MrDanS-21/gantry-system-23/V1/TechnicalDrawing.pdf

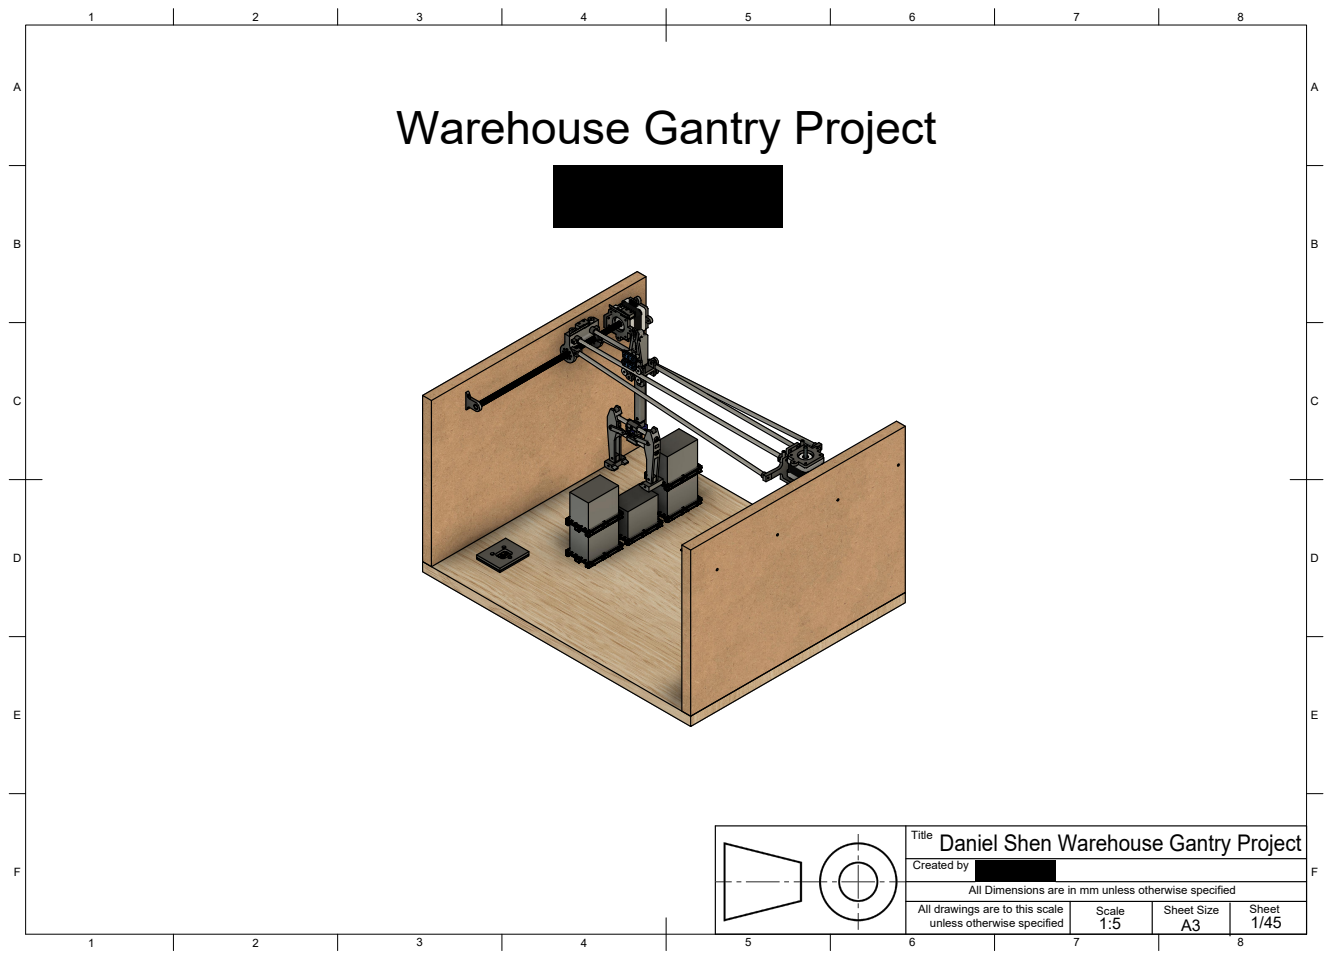
[picture p1: page 1]
Sheet Size; Created by; unless otherwise specified

Warehouse Gantry Project

Title
Daniel Shen Warehouse Gantry Project

All Dimensions are in mm unless otherwise specified

All drawings are to this scale

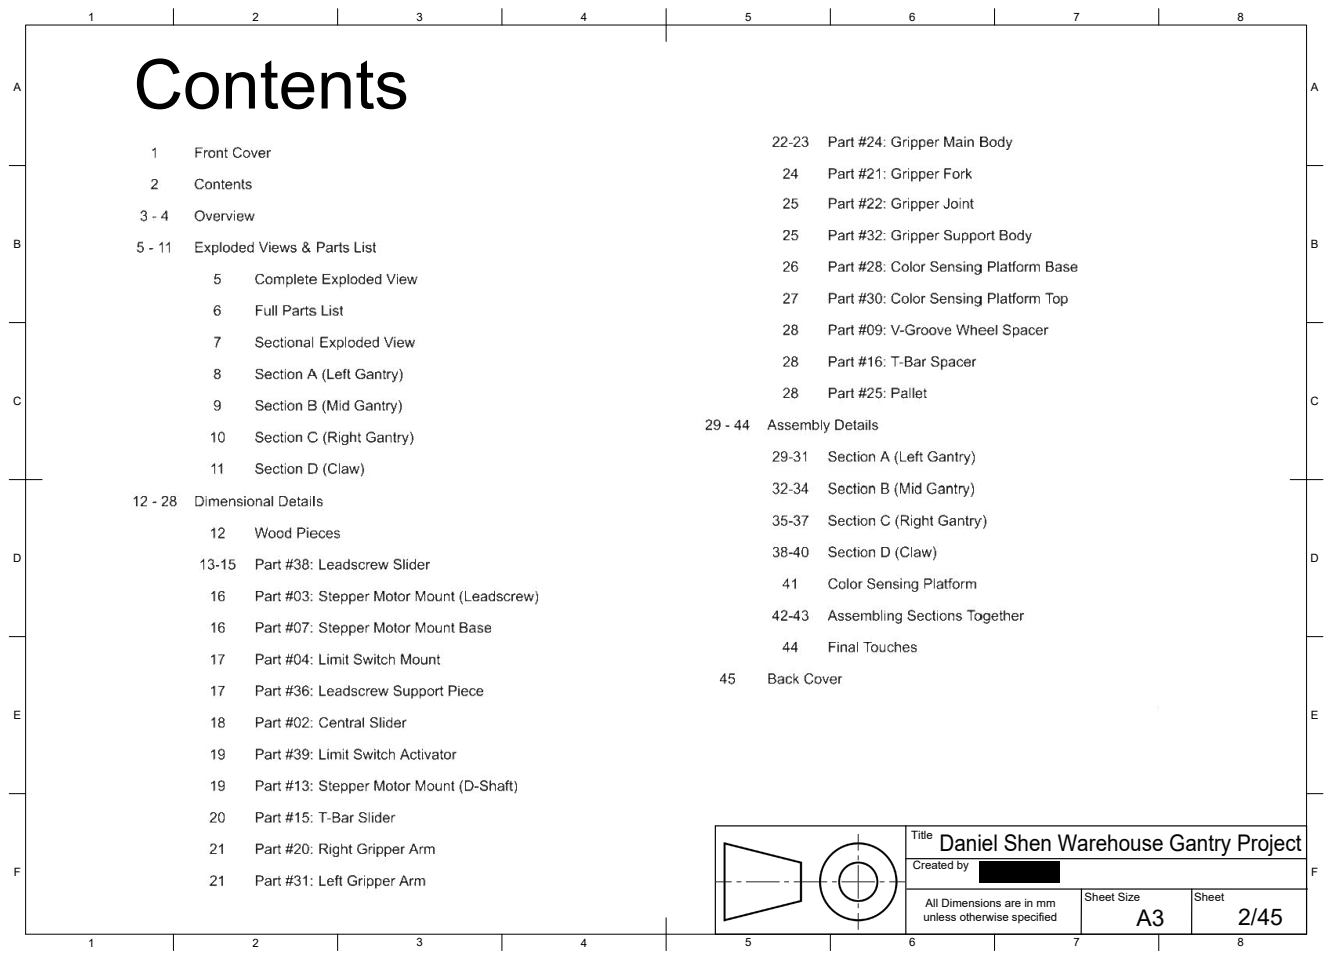
[picture p2: page 2]
Created by

Title
Daniel Shen Warehouse Gantry Project

All Dimensions are in mm

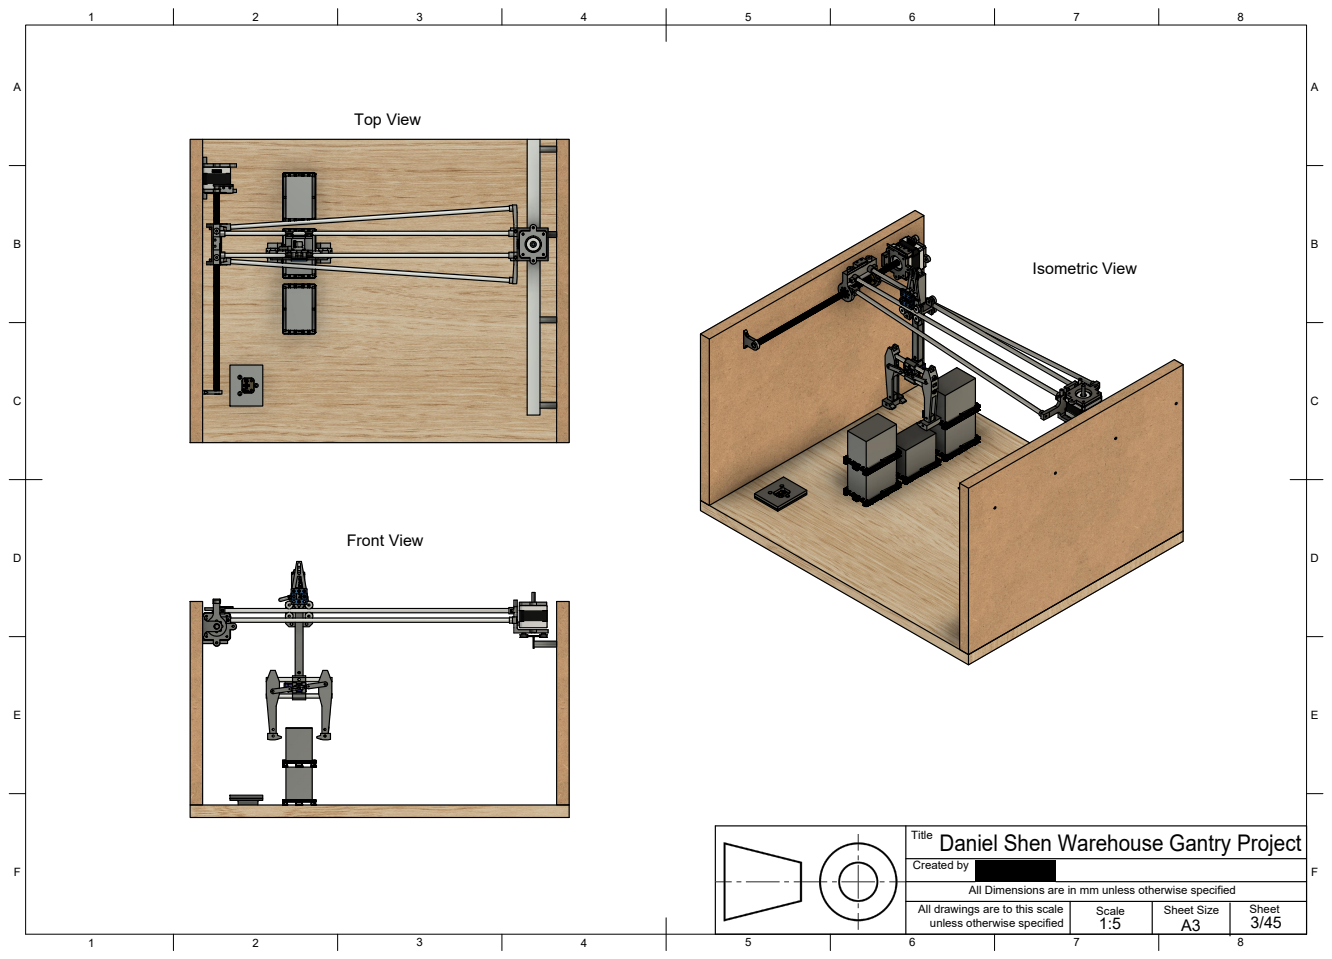
[picture p3: page 3]
Created by; Top View; Front View; Isometric View

Title
Daniel Shen Warehouse Gantry Project

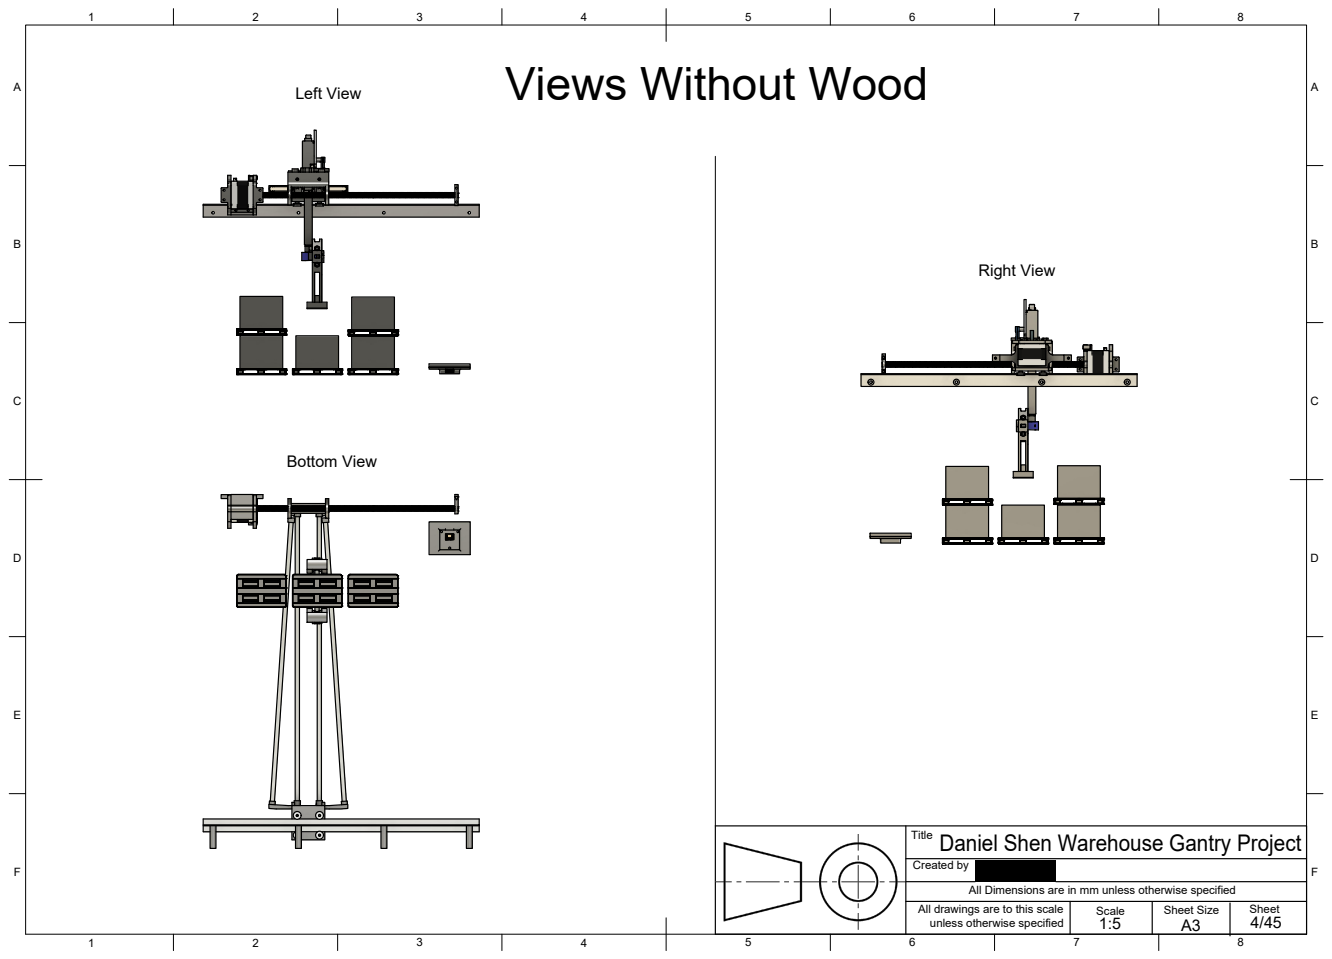
[picture p4: page 4]
Created by; Left View; Bottom View; Right View

Views Without Wood

Title
Daniel Shen Warehouse Gantry Project

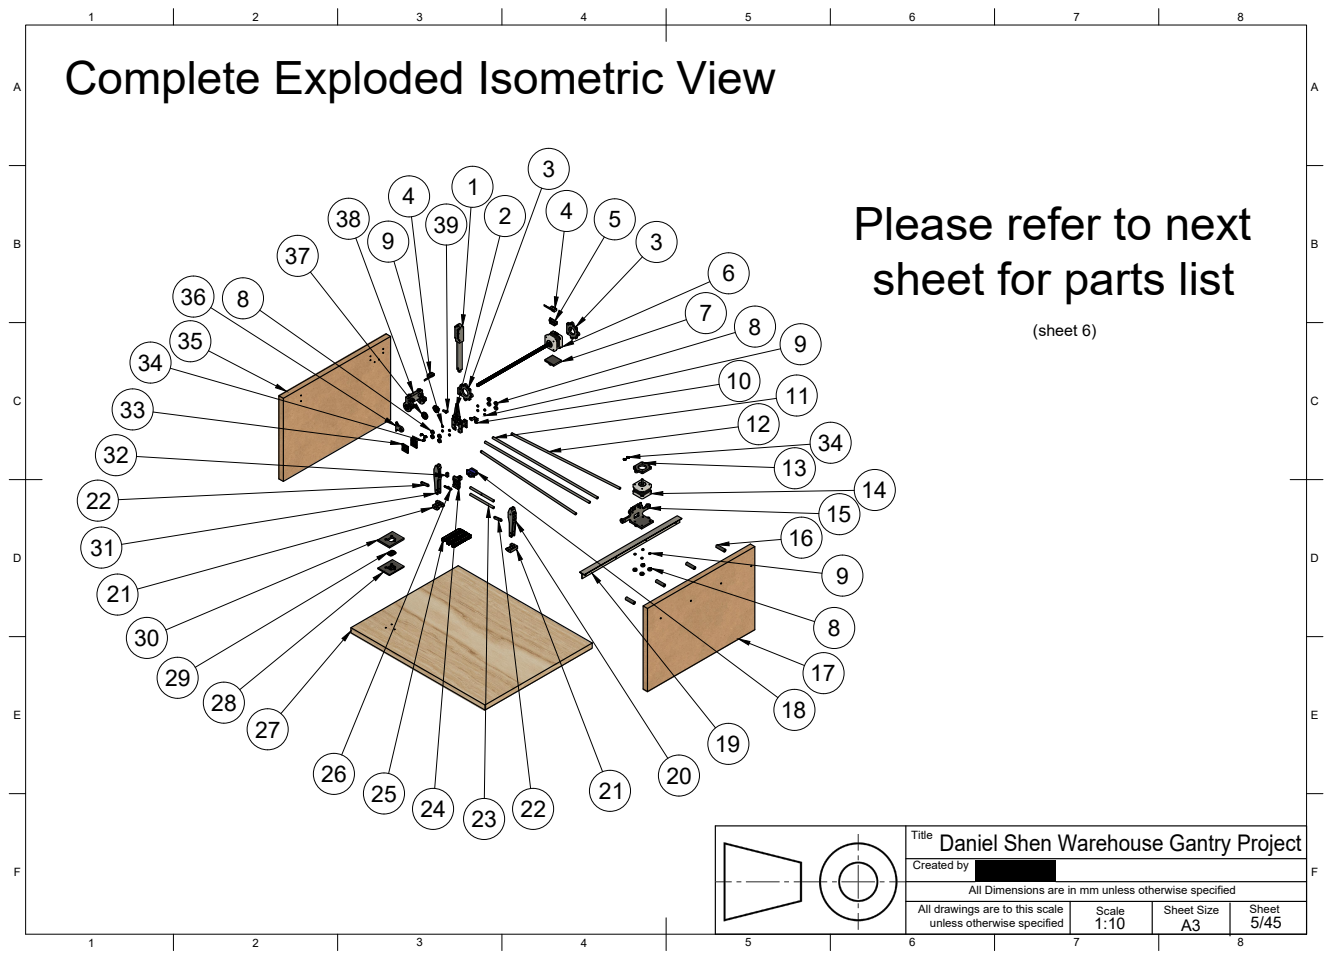
[picture p5: page 5]
Created by; (sheet 6)

Complete Exploded Isometric View

Please refer to next
sheet for parts list

Title
Daniel Shen Warehouse Gantry Project

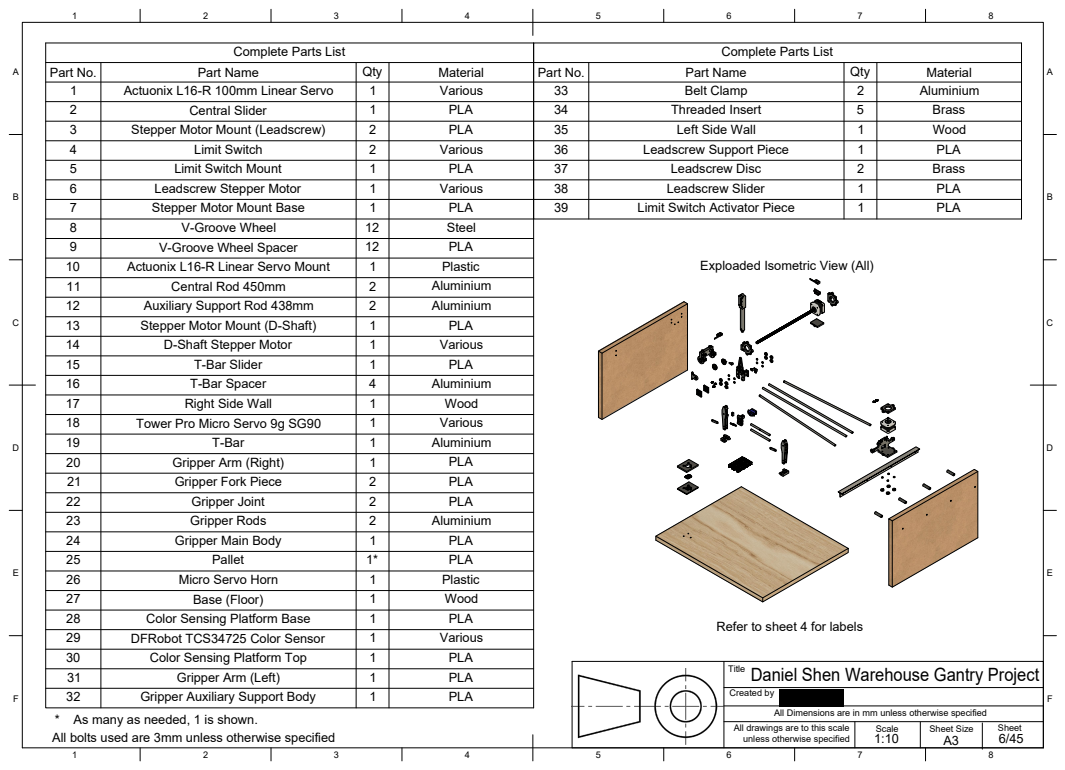
[picture p6: page 6]
Created by; Part No.; Part Name; Qty; Material; Actuonix L16-R 100mm Linear Servo; Various; Central Slider; PLA; Stepper Motor Mount (Leadscrew); Limit Switch; Limit Switch Mount; Leadscrew Stepper Motor; Stepper Motor Mount Base; V-Groove Wheel; Steel; V-Groove Wheel Spacer; Actuonix L16-R Linear Servo Mount; Plastic; Central Rod 450mm; Aluminium; Auxiliary Support Rod 438mm; Stepper Motor Mount (D-Shaft); D-Shaft Stepper Motor; T-Bar Slider; T-Bar Spacer; Right Side Wall; Wood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

Complete Parts List

* As many as needed, 1 is shown.
All bolts used are 3mm unless otherwise specified

Exploaded Isometric View (All)

Refer to sheet 4 for labels

Title
Daniel Shen Warehouse Gantry Project

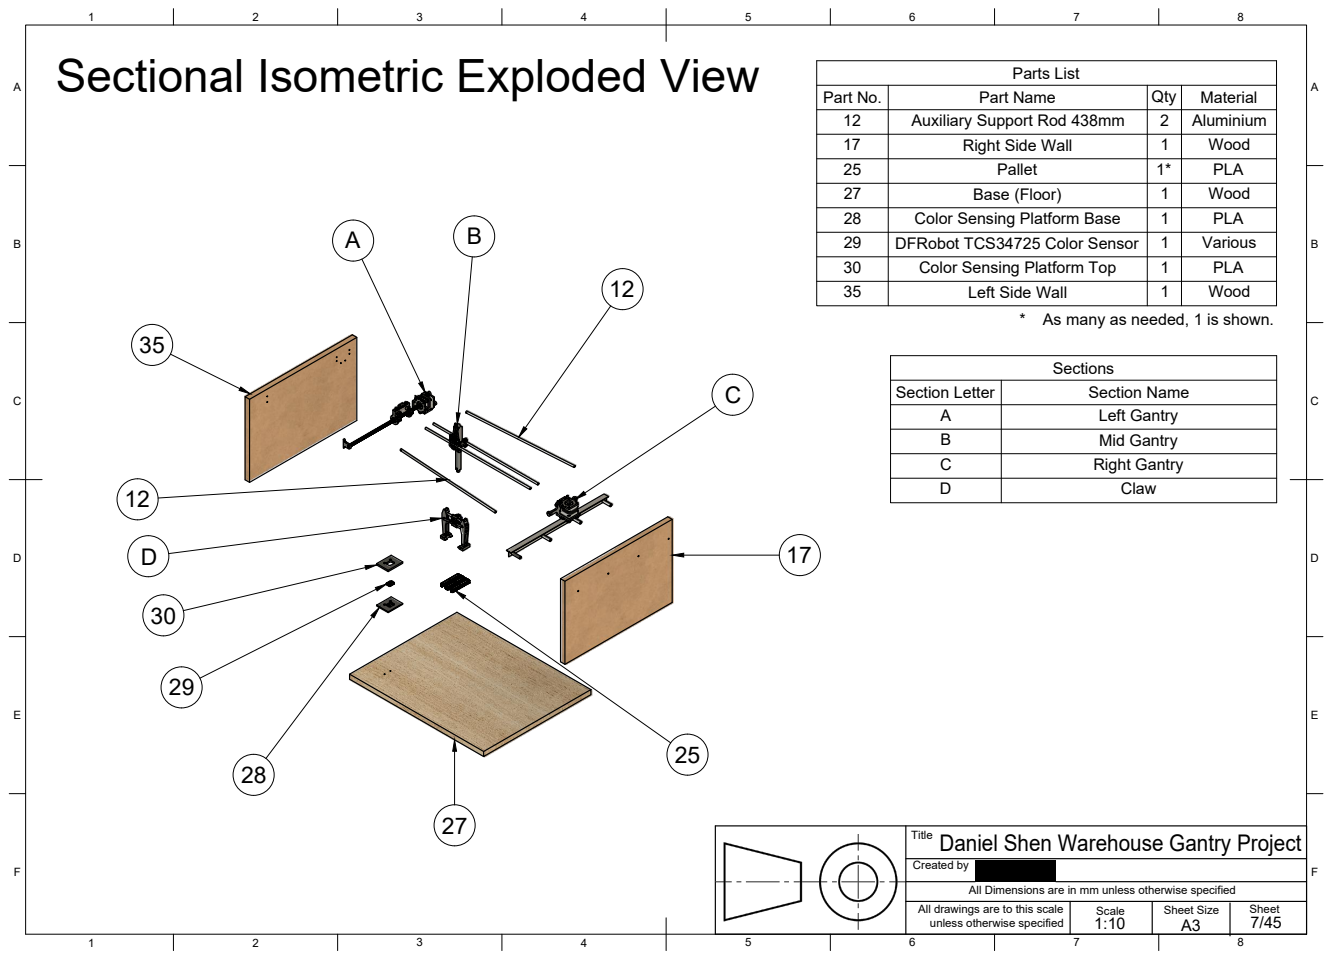
[picture p7: page 7]
Created by; Section Letter; Section Name; Left Gantry; Mid Gantry; Right Gantry; Parts List; Part No.; Part Name; Qty; Material; Auxiliary Support Rod 438mm; Aluminium; Right Side Wall; Wood; Base (Floor); Color Sensing Platform Base; PLA; DFRobot TCS34725 Color Sensor; Various; Color Sensing Platform Top; Left Side Wall

Sectional Isometric Exploded View

* As many as needed, 1 is shown.

Title
Daniel Shen Warehouse Gantry Project

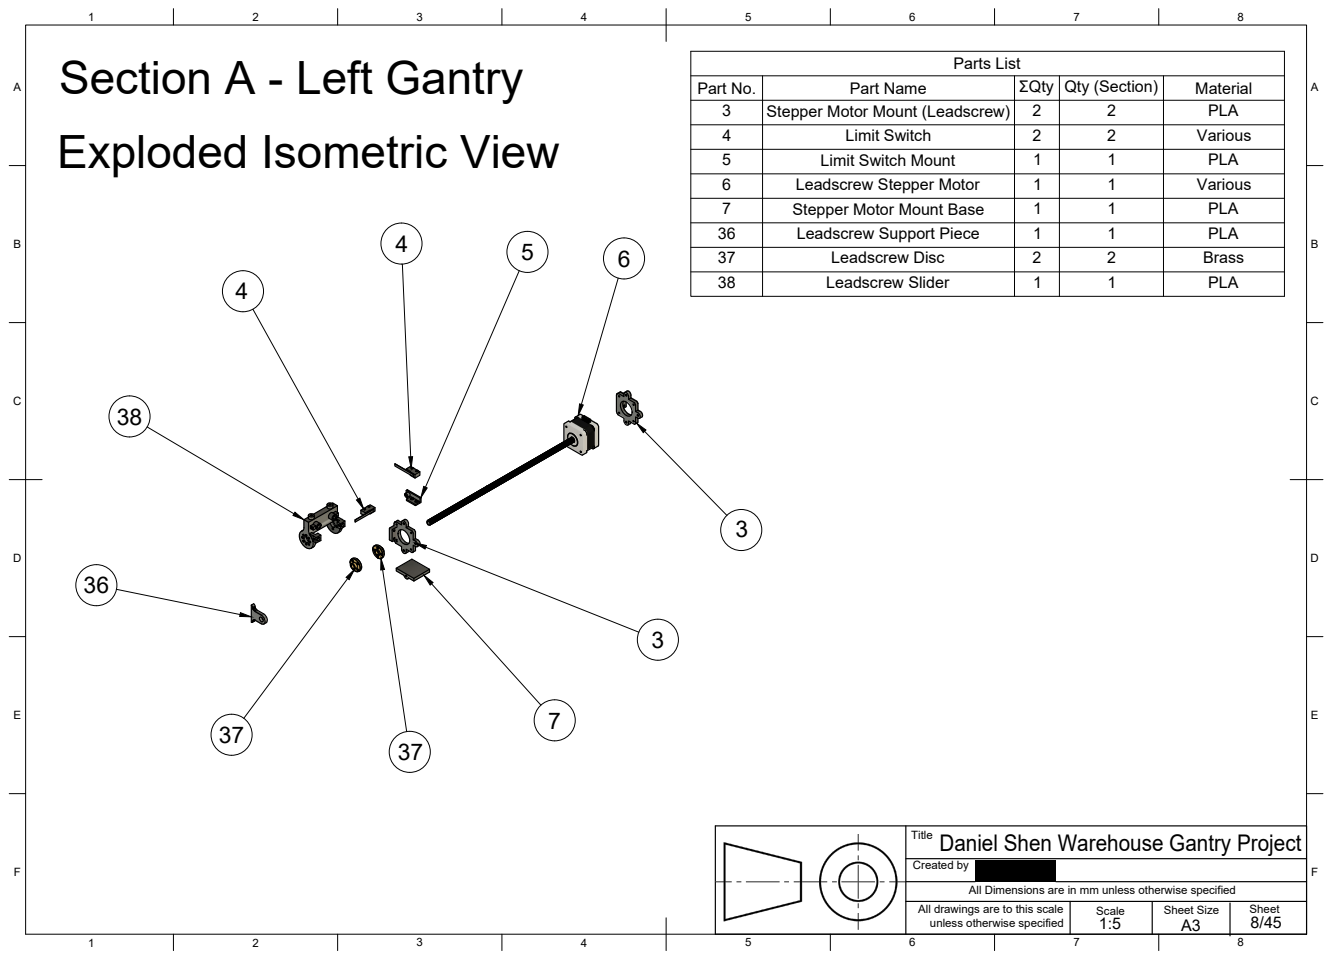
[picture p8: page 8]
Parts List

Section A - Left Gantry
Exploded Isometric View

Part No. | Part Name | ΣQty | Qty (Section) | Material
3 | Stepper Motor Mount (Leadscrew) | 2 | 2 | PLA
4 | Limit Switch | 2 | 2 | Various
5 | Limit Switch Mount | 1 | 1 | PLA
6 | Leadscrew Stepper Motor | 1 | 1 | Various
7 | Stepper Motor Mount Base | 1 | 1 | PLA
36 | Leadscrew Support Piece | 1 | 1 | PLA
37 | Leadscrew Disc | 2 | 2 | Brass
38 | Leadscrew Slider | 1 | 1 | PLA

Title Daniel Shen Warehouse Gantry Project

Created by

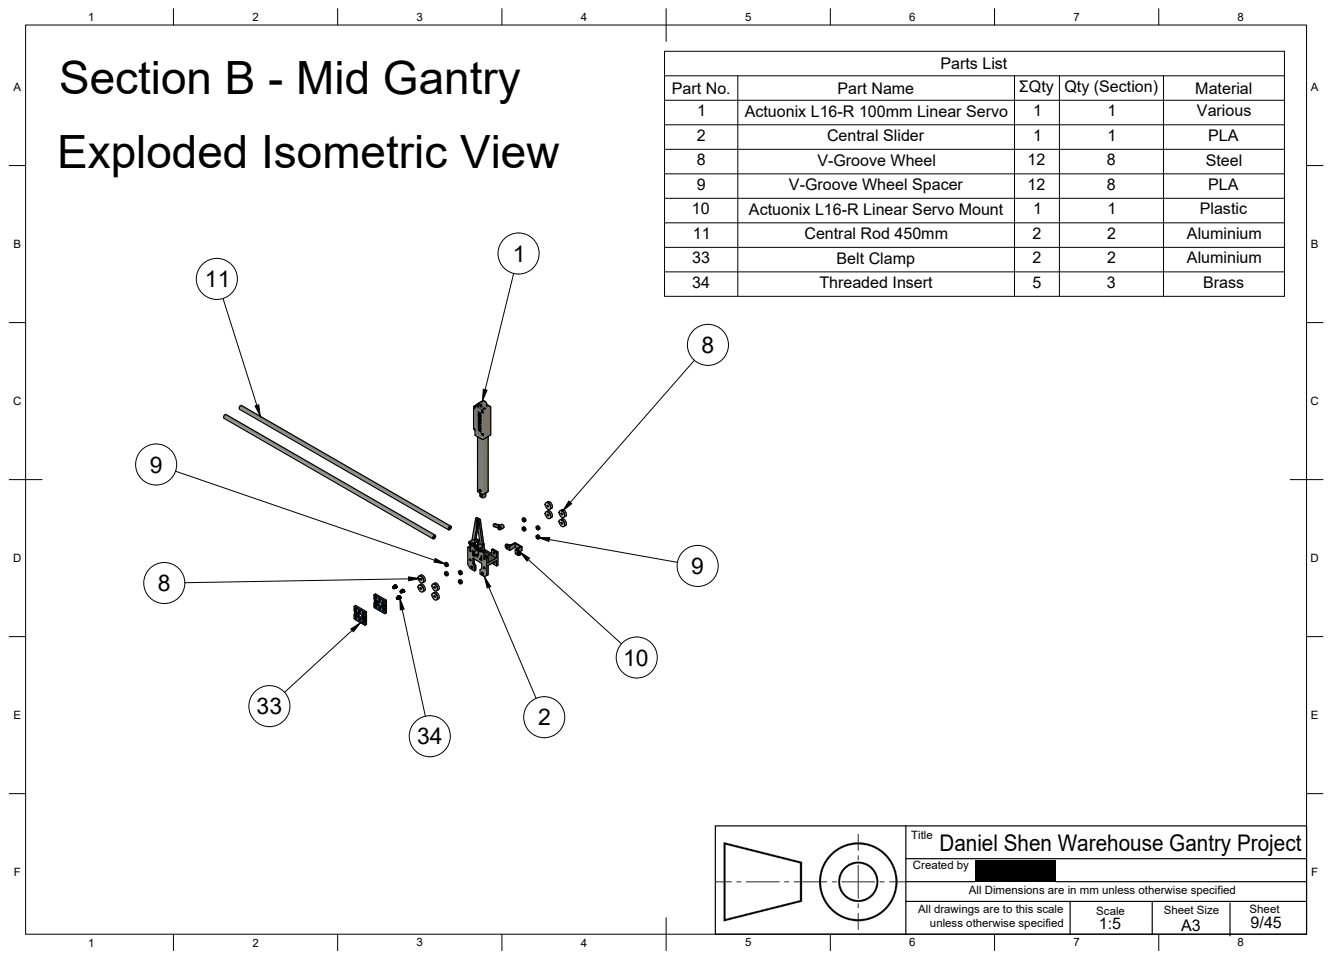
[picture p9: page 9]
Parts List

Section B - Mid Gantry
Exploded Isometric View

Part No. | Part Name | ΣQty | Qty (Section) | Material
1 | Actuonix L16-R 100mm Linear Servo | 1 | 1 | Various
2 | Central Slider | 1 | 1 | PLA
8 | V-Groove Wheel | 12 | 8 | Steel
9 | V-Groove Wheel Spacer | 12 | 8 | PLA
10 | Actuonix L16-R Linear Servo Mount | 1 | 1 | Plastic
11 | Central Rod 450mm | 2 | 2 | Aluminium
33 | Belt Clamp | 2 | 2 | Aluminium
34 | Threaded Insert | 5 | 3 | Brass

Title Daniel Shen Warehouse Gantry Project

Created by

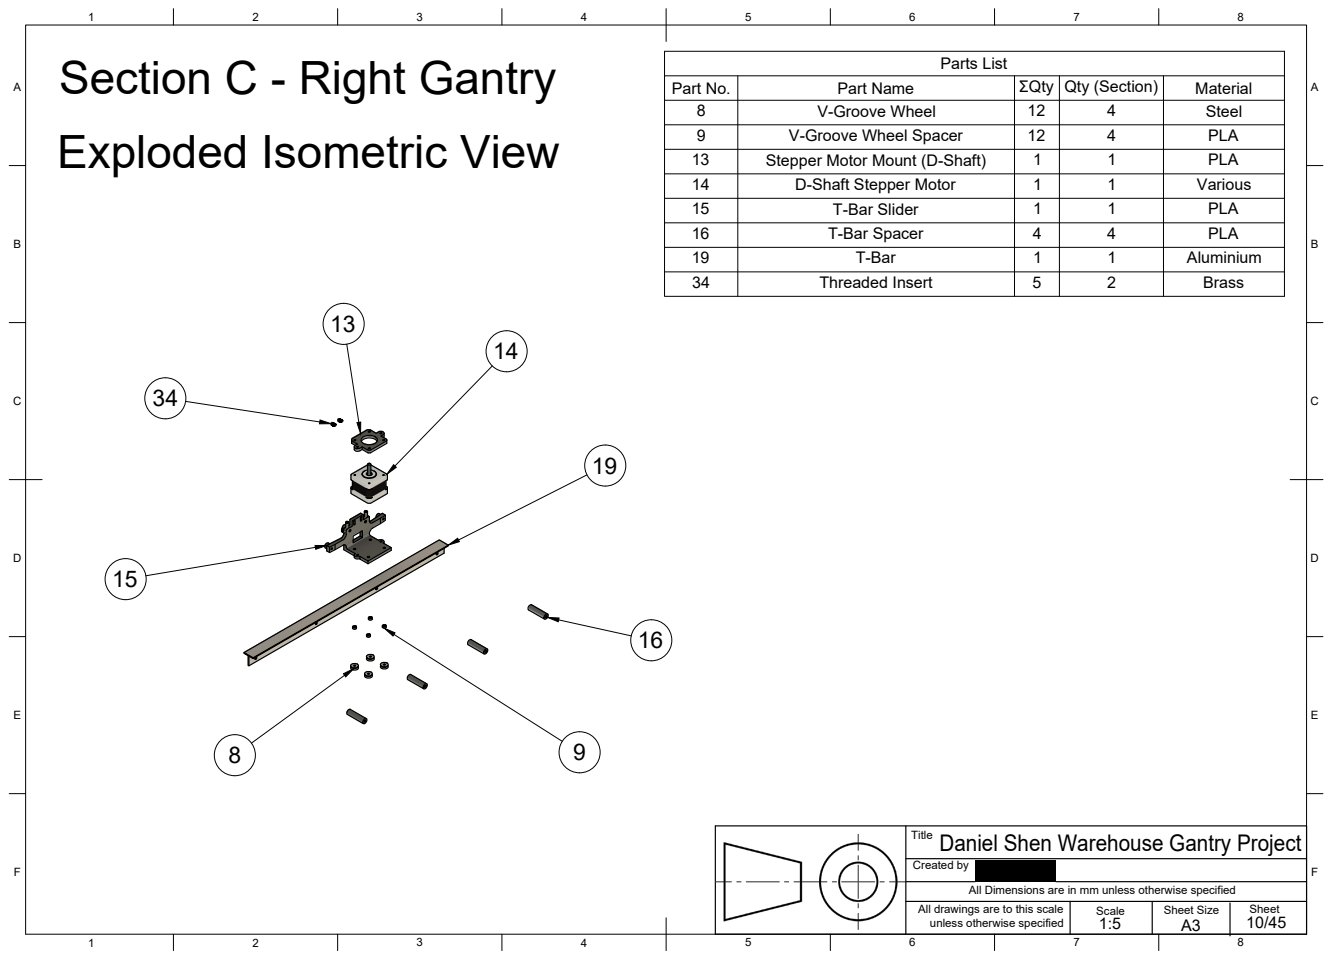
[picture p10: page 10]
Parts List

Section C - Right Gantry
Exploded Isometric View

Part No. | Part Name | ΣQty | Qty (Section) | Material
8 | V-Groove Wheel | 12 | 4 | Steel
9 | V-Groove Wheel Spacer | 12 | 4 | PLA
13 | Stepper Motor Mount (D-Shaft) | 1 | 1 | PLA
14 | D-Shaft Stepper Motor | 1 | 1 | Various
15 | T-Bar Slider | 1 | 1 | PLA
16 | T-Bar Spacer | 4 | 4 | PLA
19 | T-Bar | 1 | 1 | Aluminium
34 | Threaded Insert | 5 | 2 | Brass

Title Daniel Shen Warehouse Gantry Project

Created by

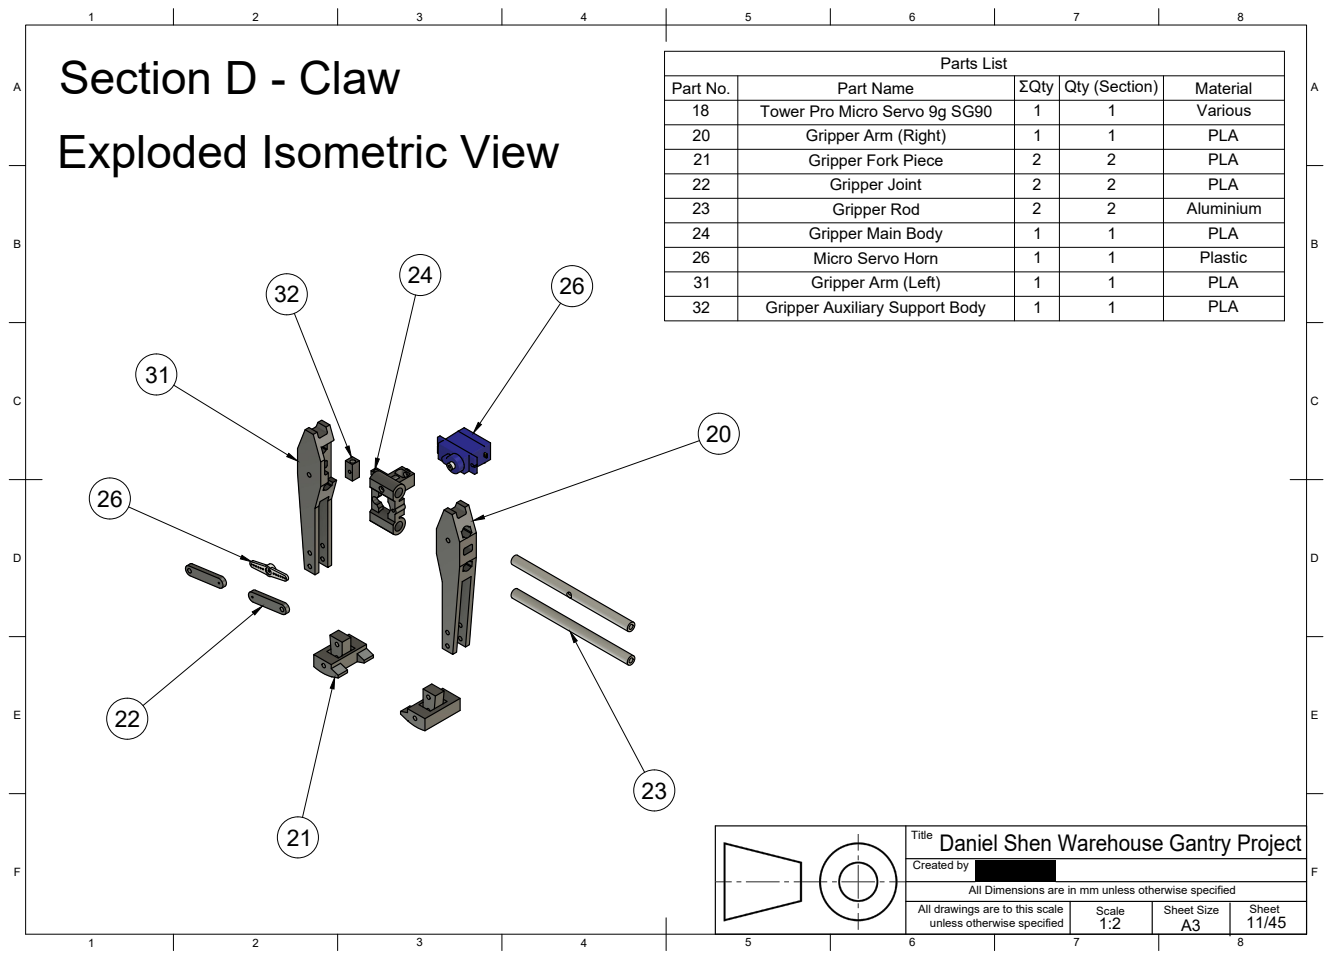
[picture p11: page 11]
Parts List

Section D - Claw
Exploded Isometric View

Part No. | Part Name | ΣQty | Qty (Section) | Material
18 | Tower Pro Micro Servo 9g SG90 | 1 | 1 | Various
20 | Gripper Arm (Right) | 1 | 1 | PLA
21 | Gripper Fork Piece | 2 | 2 | PLA
22 | Gripper Joint | 2 | 2 | PLA
23 | Gripper Rod | 2 | 2 | Aluminium
24 | Gripper Main Body | 1 | 1 | PLA
26 | Micro Servo Horn | 1 | 1 | Plastic
31 | Gripper Arm (Left) | 1 | 1 | PLA
32 | Gripper Auxiliary Support Body | 1 | 1 | PLA

Title Daniel Shen Warehouse Gantry Project

Created by

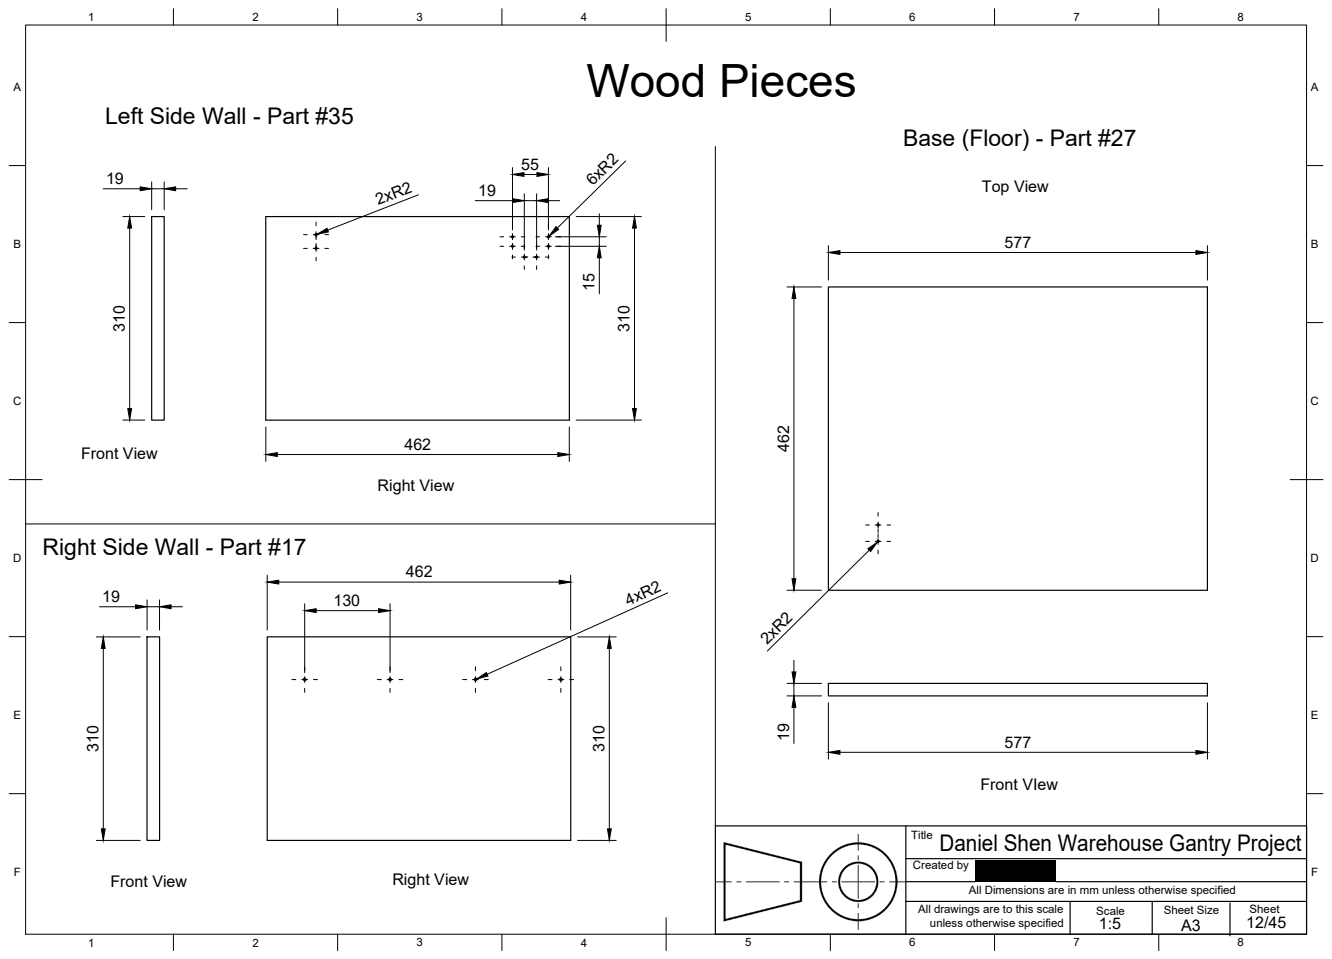
[picture p12: page 12]
Wood Pieces; Right Side Wall - Part #17 310; Front View; Right View; Top View; Front VIew

Left Side Wall - Part #35

Base (Floor) - Part #27

Title Daniel Shen Warehouse Gantry Project

Created by

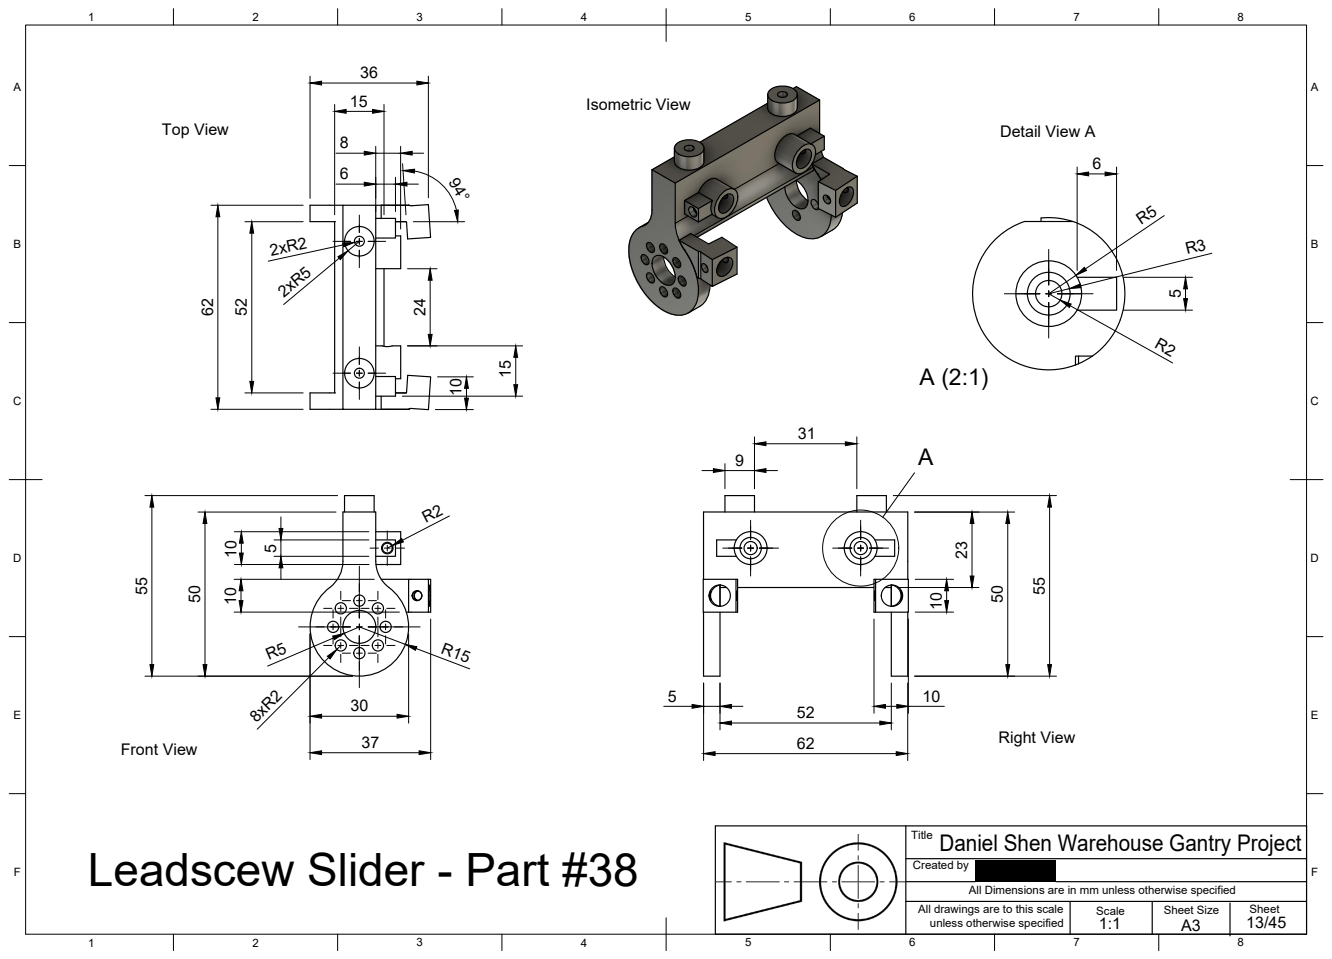
[picture p13: page 13]
Front View; Right View; Top View; Detail View A; Isometric View

Title Daniel Shen Warehouse Gantry Project

Leadscew Slider - Part #38

Created by

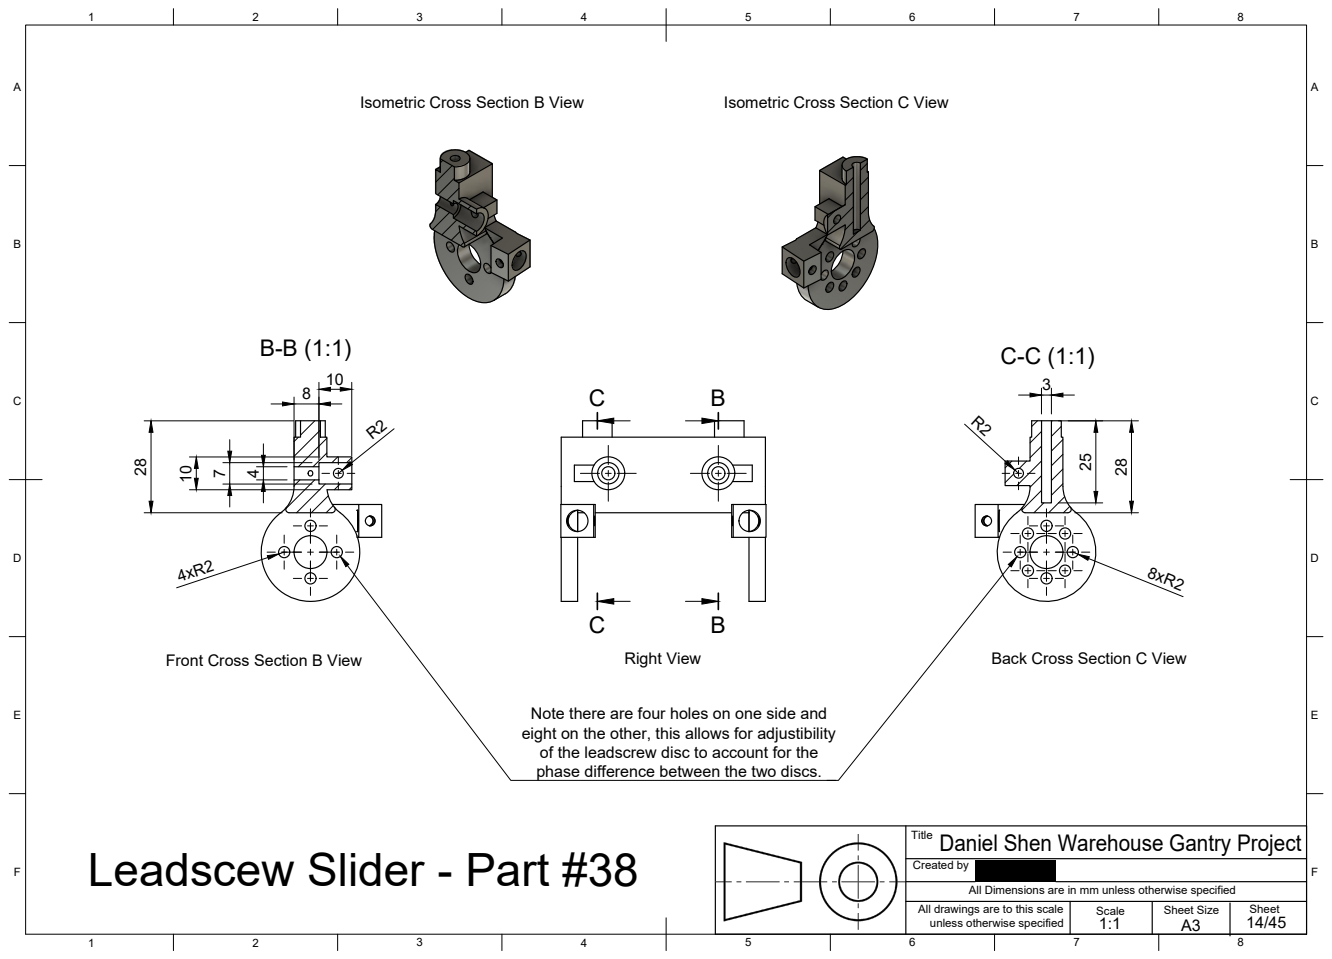
[picture p14: page 14]
Front Cross Section B View; Right View; Back Cross Section C View; Isometric Cross Section B View; Isometric Cross Section C View

Note there are four holes on one side and
eight on the other, this allows for adjustibility
of the leadscrew disc to account for the
phase difference between the two discs.

Title Daniel Shen Warehouse Gantry Project

Leadscew Slider - Part #38

Created by

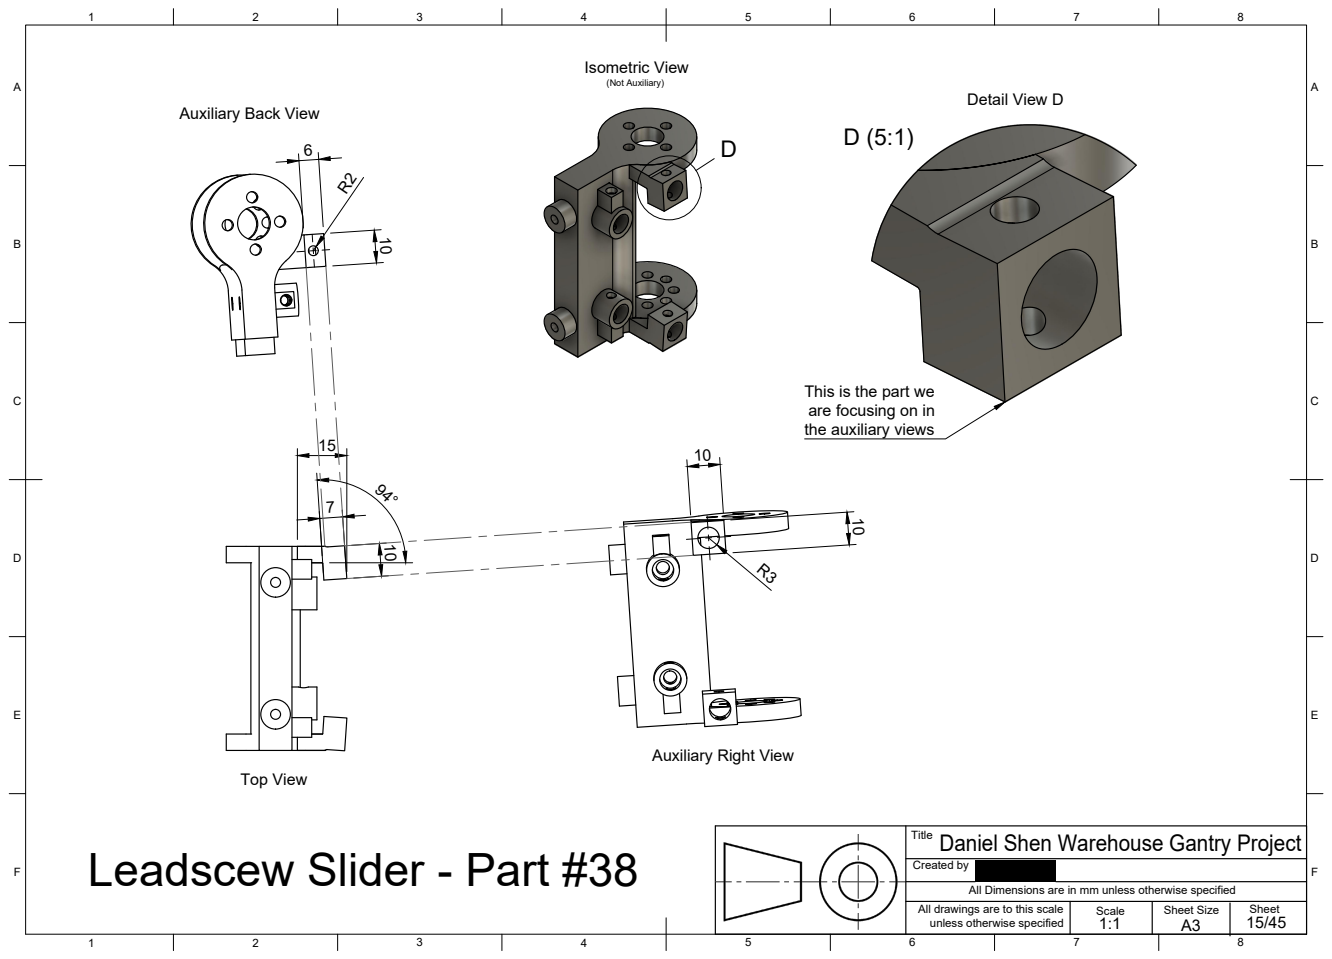
[picture p15: page 15]
Top View; Isometric View; Detail View D; (Not Auxiliary)

Auxiliary Back View

This is the part we
are focusing on in
the auxiliary views

Auxiliary Right View

Title Daniel Shen Warehouse Gantry Project

Leadscew Slider - Part #38

Created by

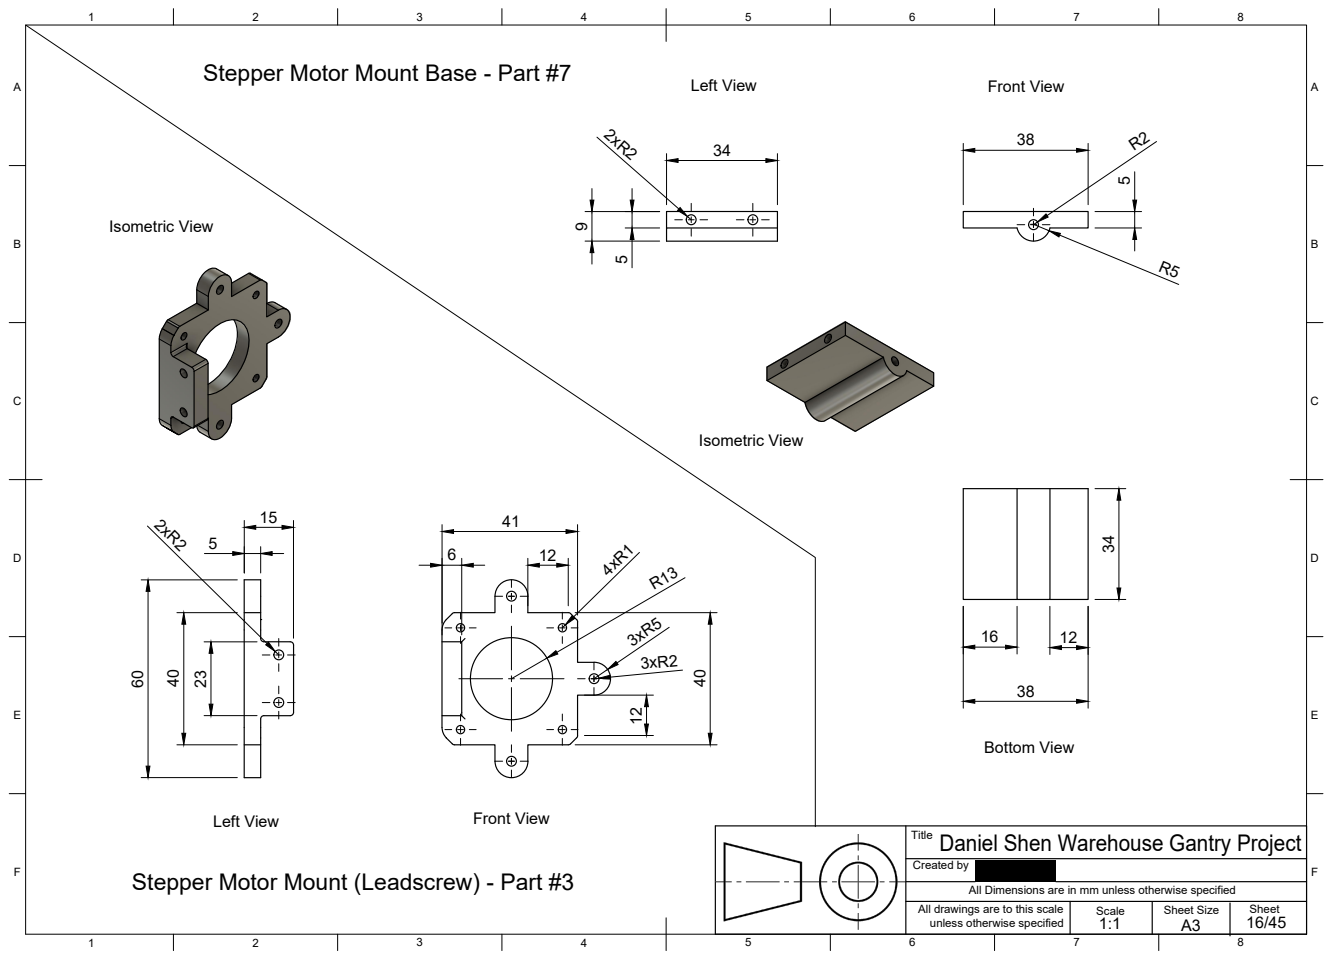
[picture p16: page 16]
Left View; Front View; Bottom View; Isometric View

Stepper Motor Mount Base - Part #7

Title Daniel Shen Warehouse Gantry Project

Created by

Stepper Motor Mount (Leadscrew) - Part #3

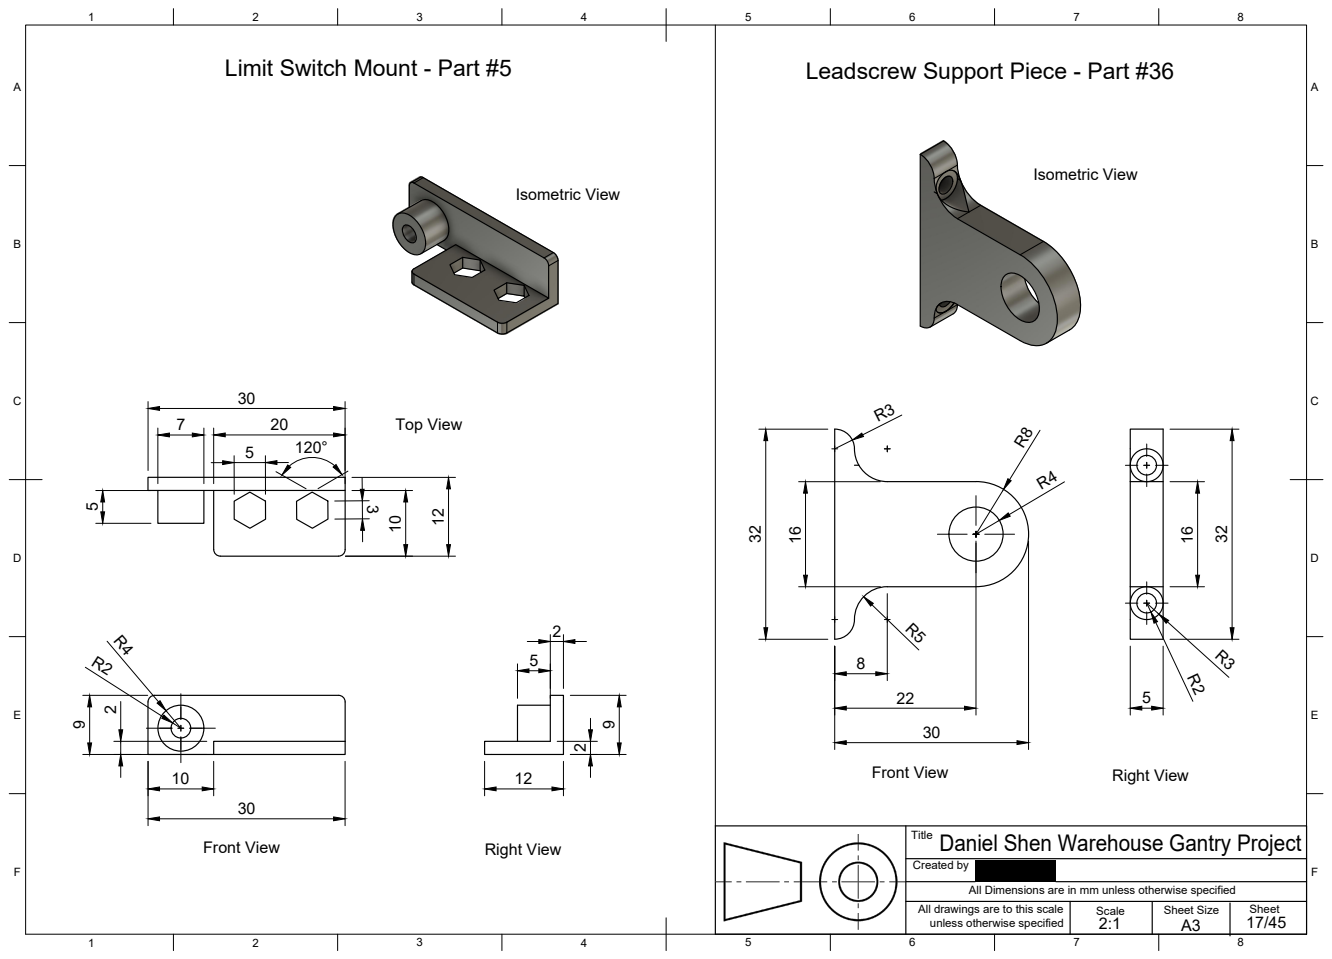
[picture p17: page 17]
Limit Switch Mount - Part #5; Leadscrew Support Piece - Part #36; Isometric View; Top View; Front View; Right View

Title Daniel Shen Warehouse Gantry Project

Created by

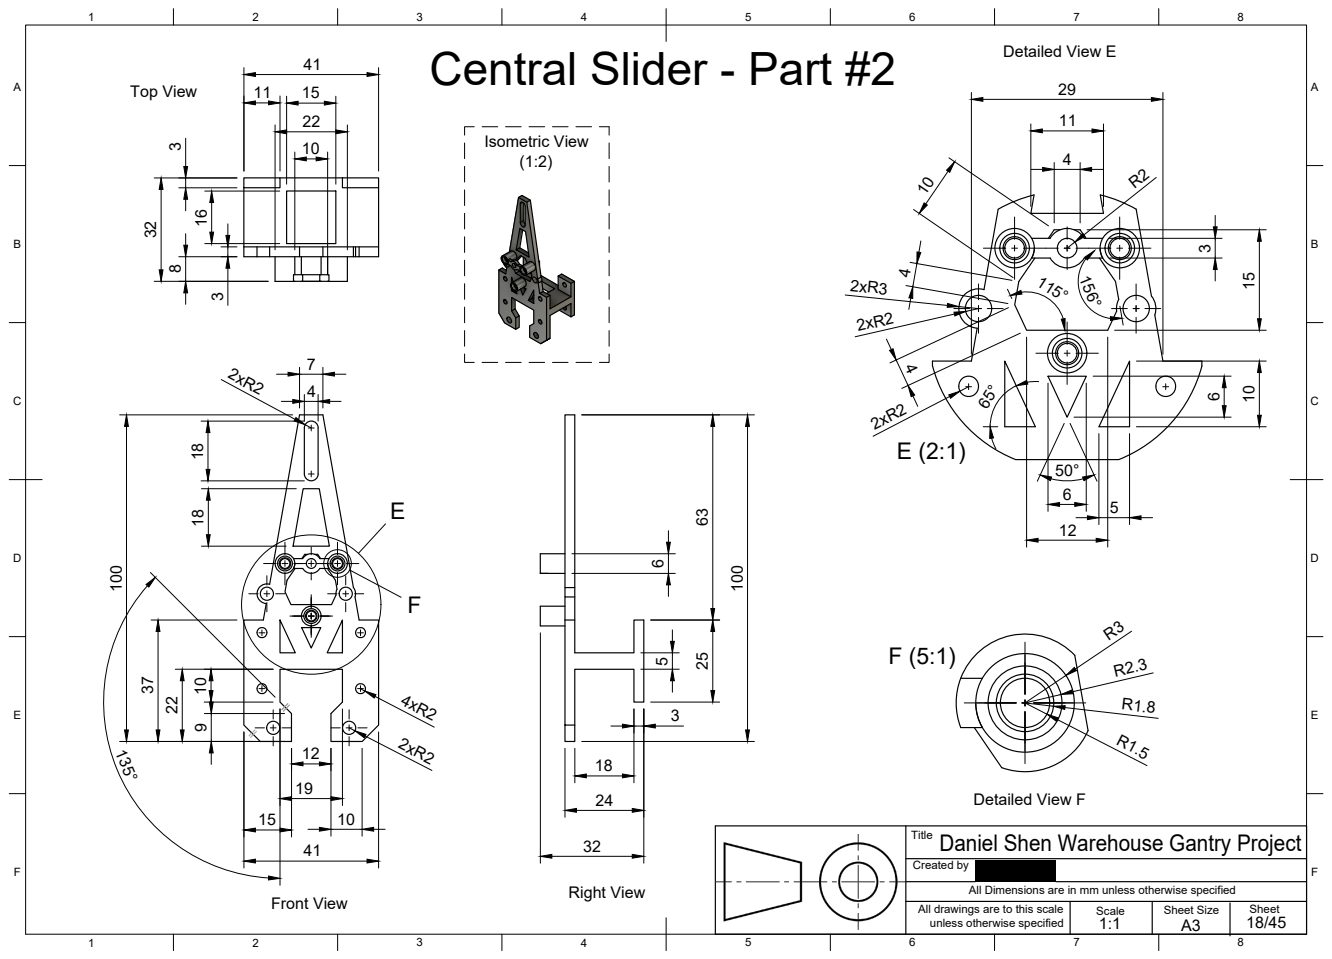
[picture p18: page 18]
Isometric View; Top View; Front View; Right View; Detailed View E; Detailed View F

Central Slider - Part #2

Title Daniel Shen Warehouse Gantry Project

Created by

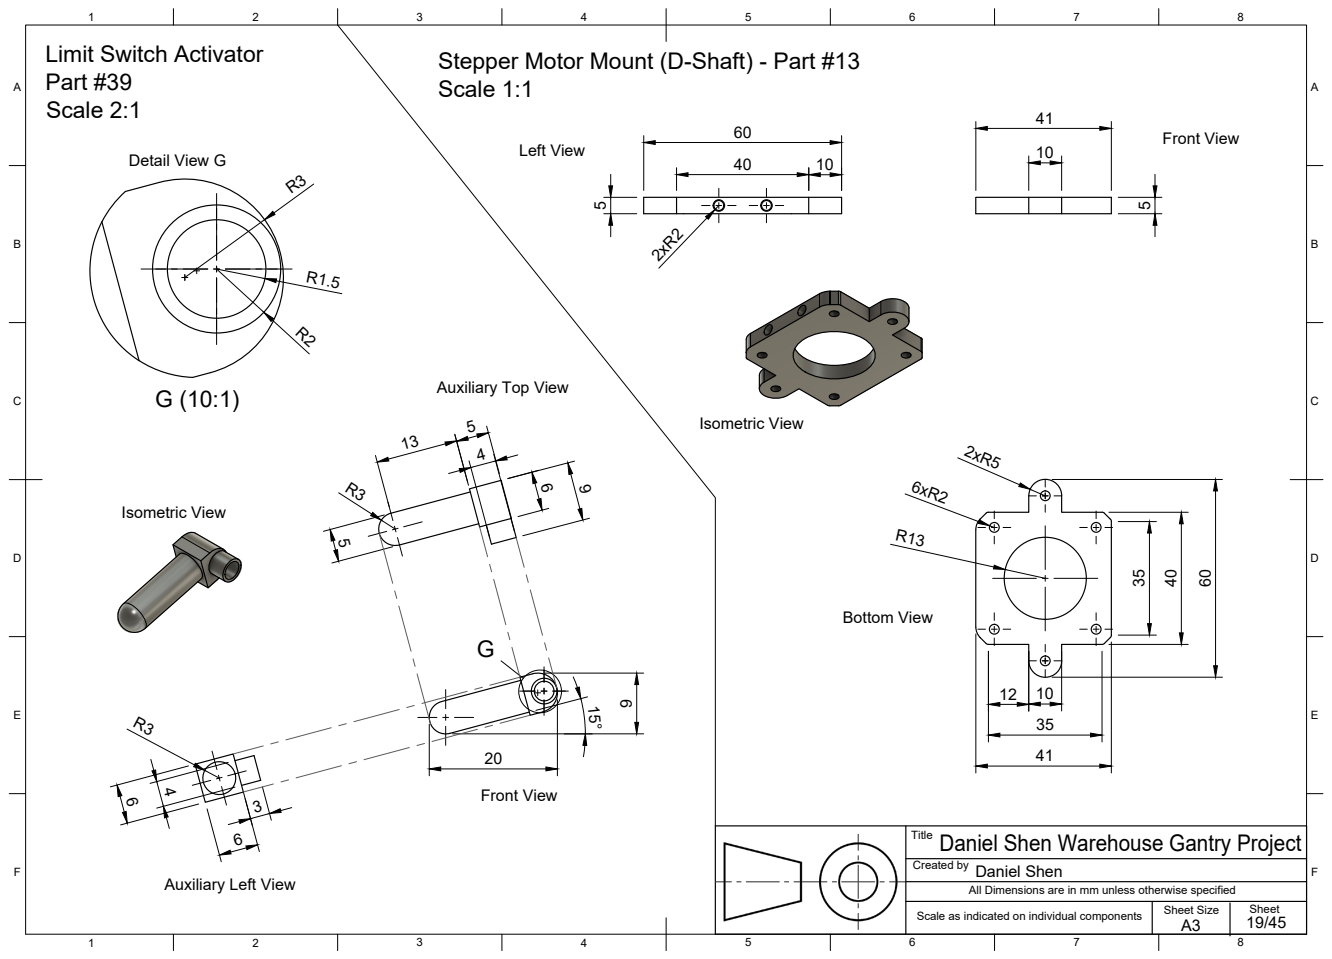
[picture p19: page 19]
Created by; Scale as indicated on individual components; Daniel Shen; Limit Switch Activator Part #39 Scale 2:1; Front View; Isometric View; Detail View G; Left View; Bottom View

Stepper Motor Mount (D-Shaft) - Part #13
Scale 1:1

Auxiliary Top View

Title
Daniel Shen Warehouse Gantry Project

Auxiliary Left View

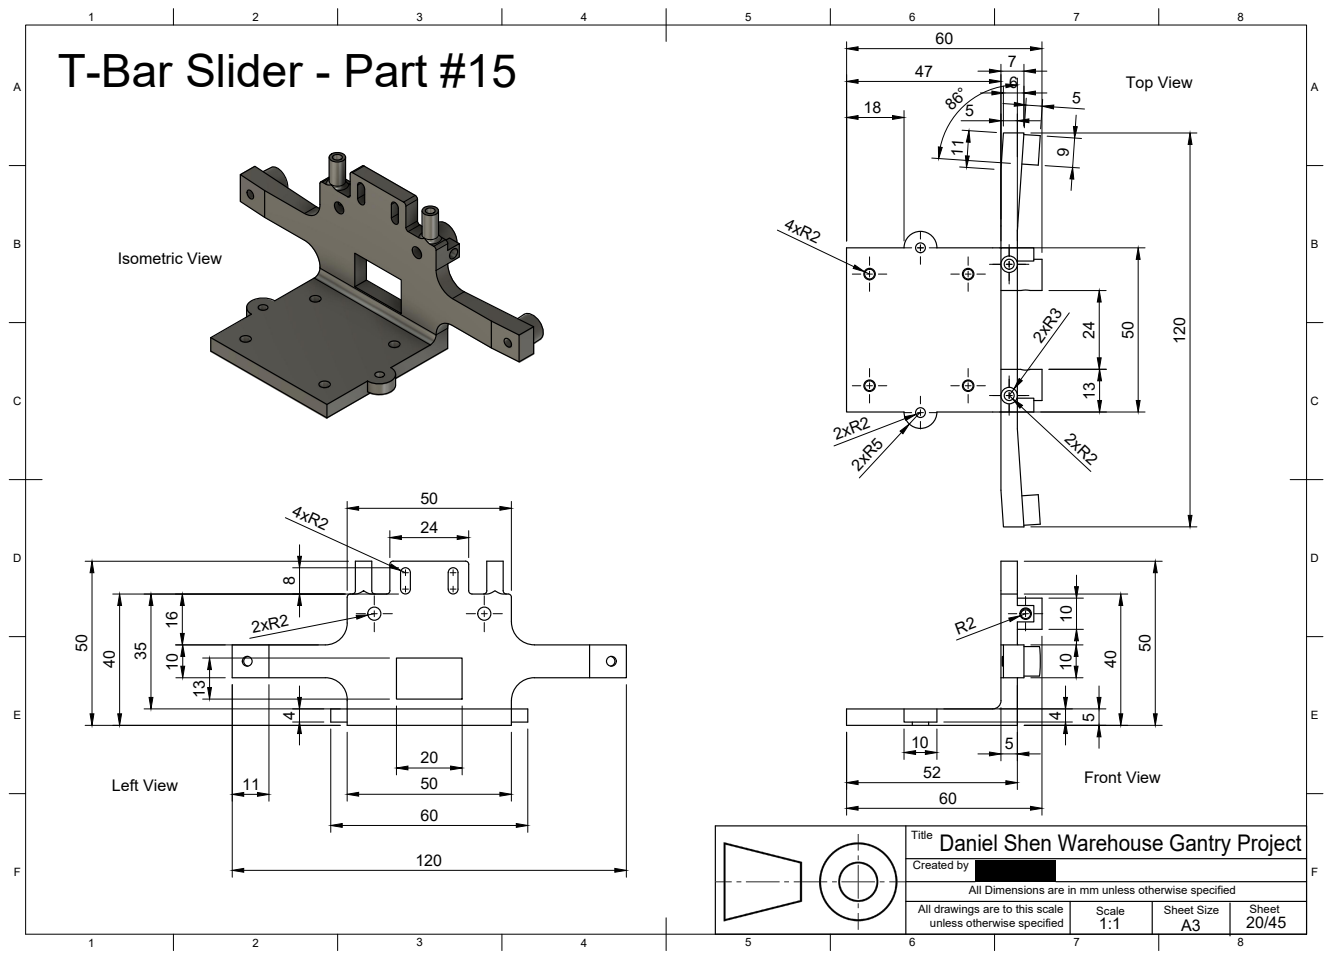
[picture p20: page 20]
Isometric View; Left View; Front View; Top View

T-Bar Slider - Part #15

Title Daniel Shen Warehouse Gantry Project

Created by

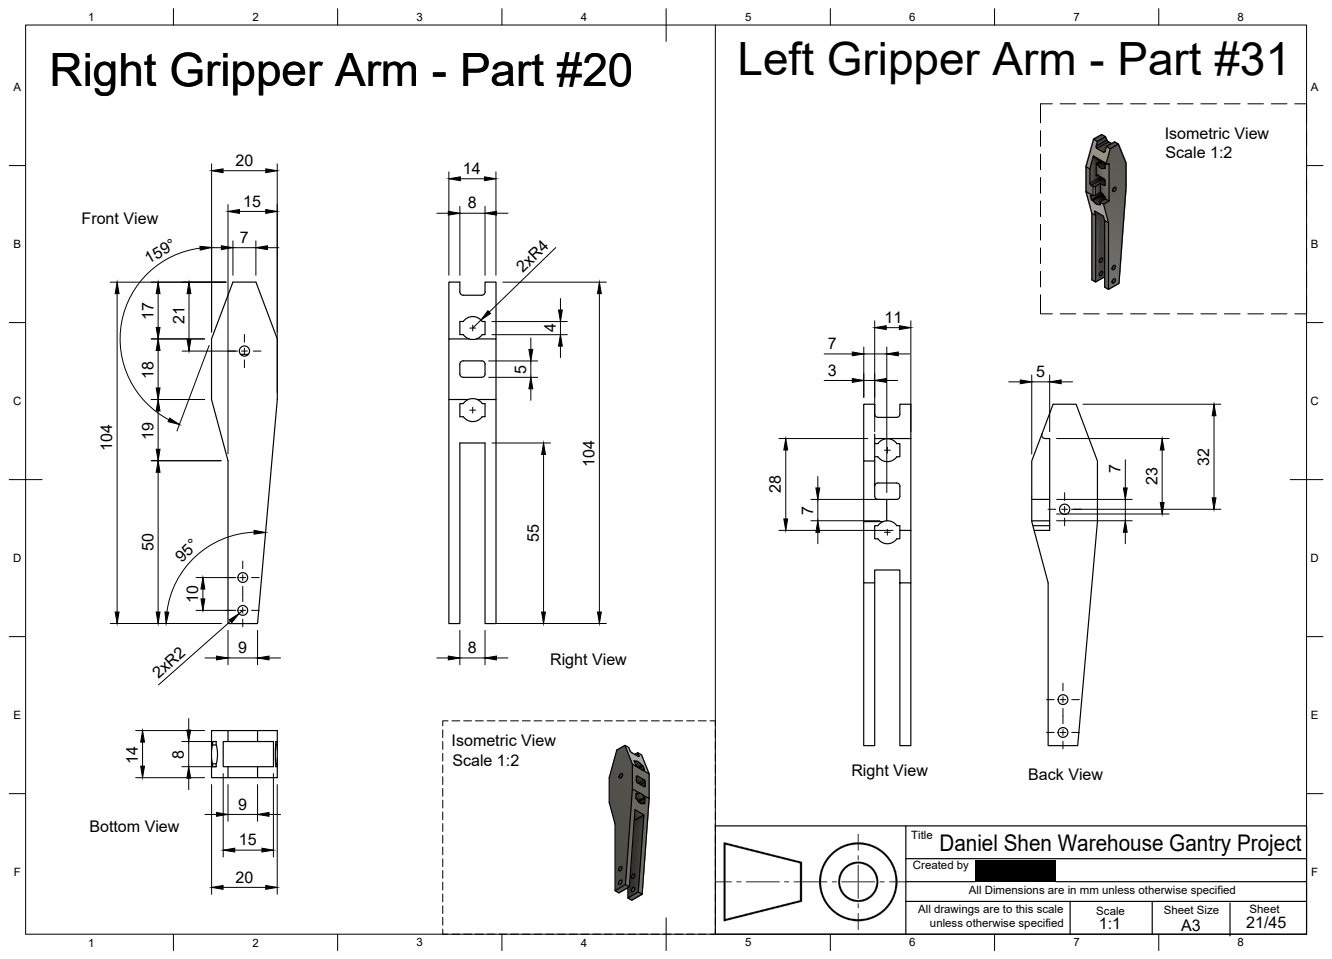
[picture p21: page 21]
Front View; Right View; Bottom View; Isometric View; Scale 1:2 10 21; Right Gripper Arm - Part #20; Left Gripper Arm - Part #31 28; Back View; Isometric View Scale 1:2

Right Gripper Arm - Part #20

Title Daniel Shen Warehouse Gantry Project

Created by

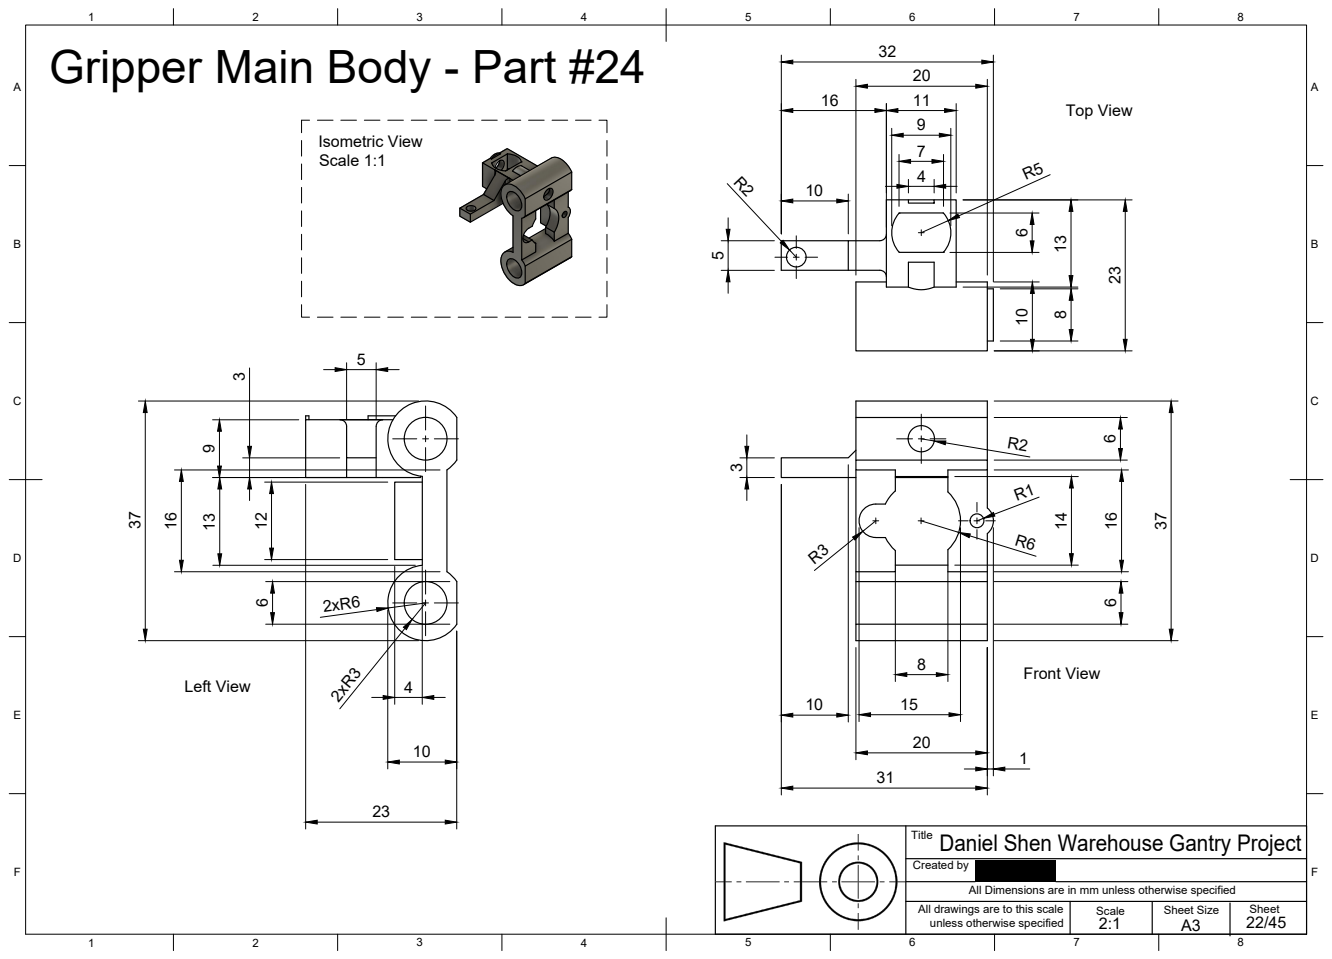
[picture p22: page 22]
Isometric View Scale 1:1; Left View; Front View; Top View

Gripper Main Body - Part #24

Title Daniel Shen Warehouse Gantry Project

Created by

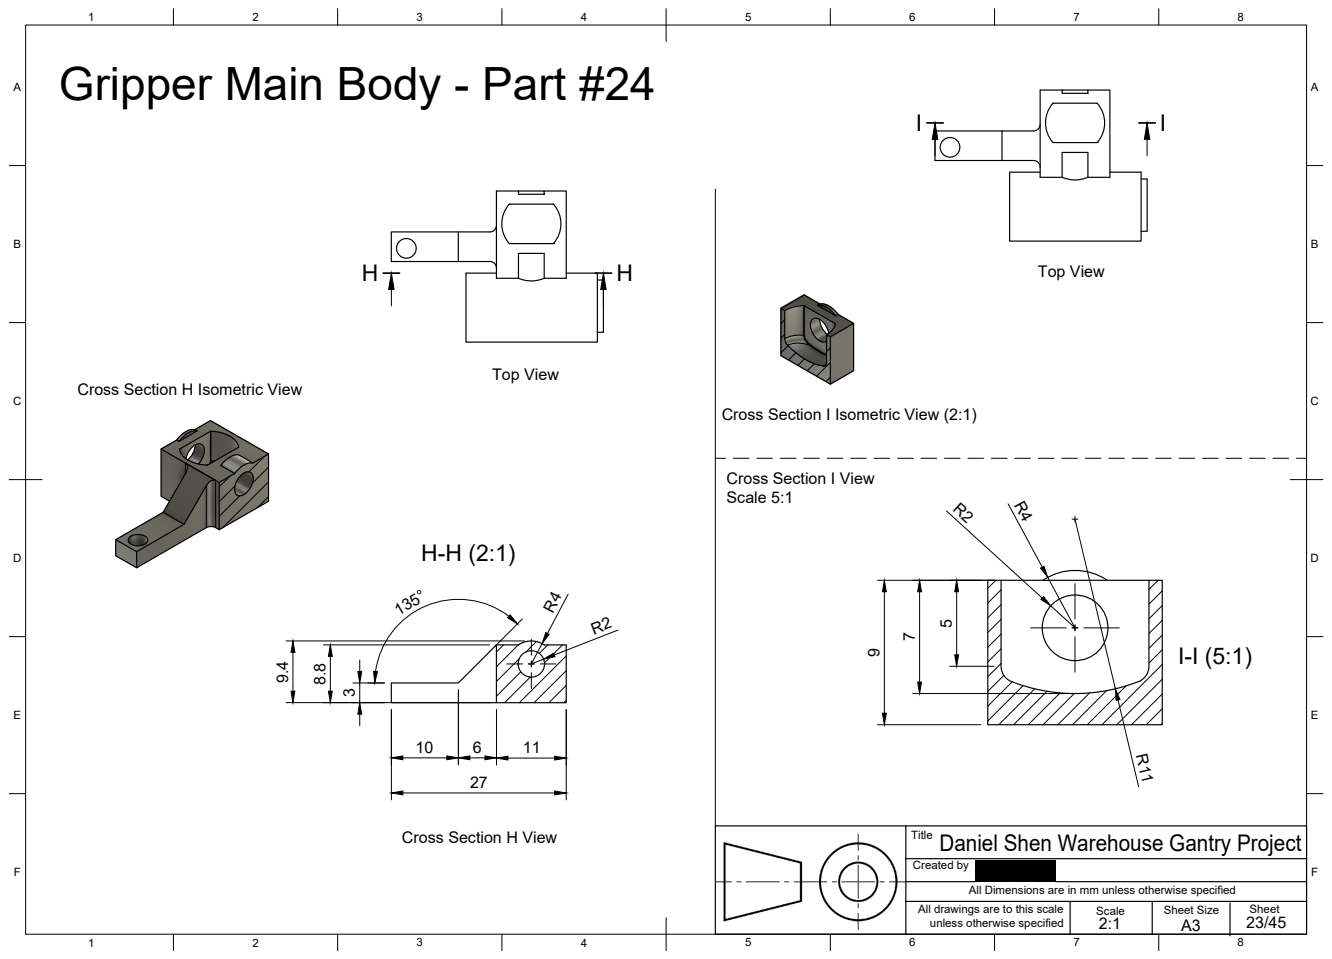
[picture p23: page 23]
Top View

Gripper Main Body - Part #24

Cross Section H Isometric View

Cross Section I Isometric View (2:1)

Cross Section I View
Scale 5:1

Cross Section H View

Title Daniel Shen Warehouse Gantry Project

Created by

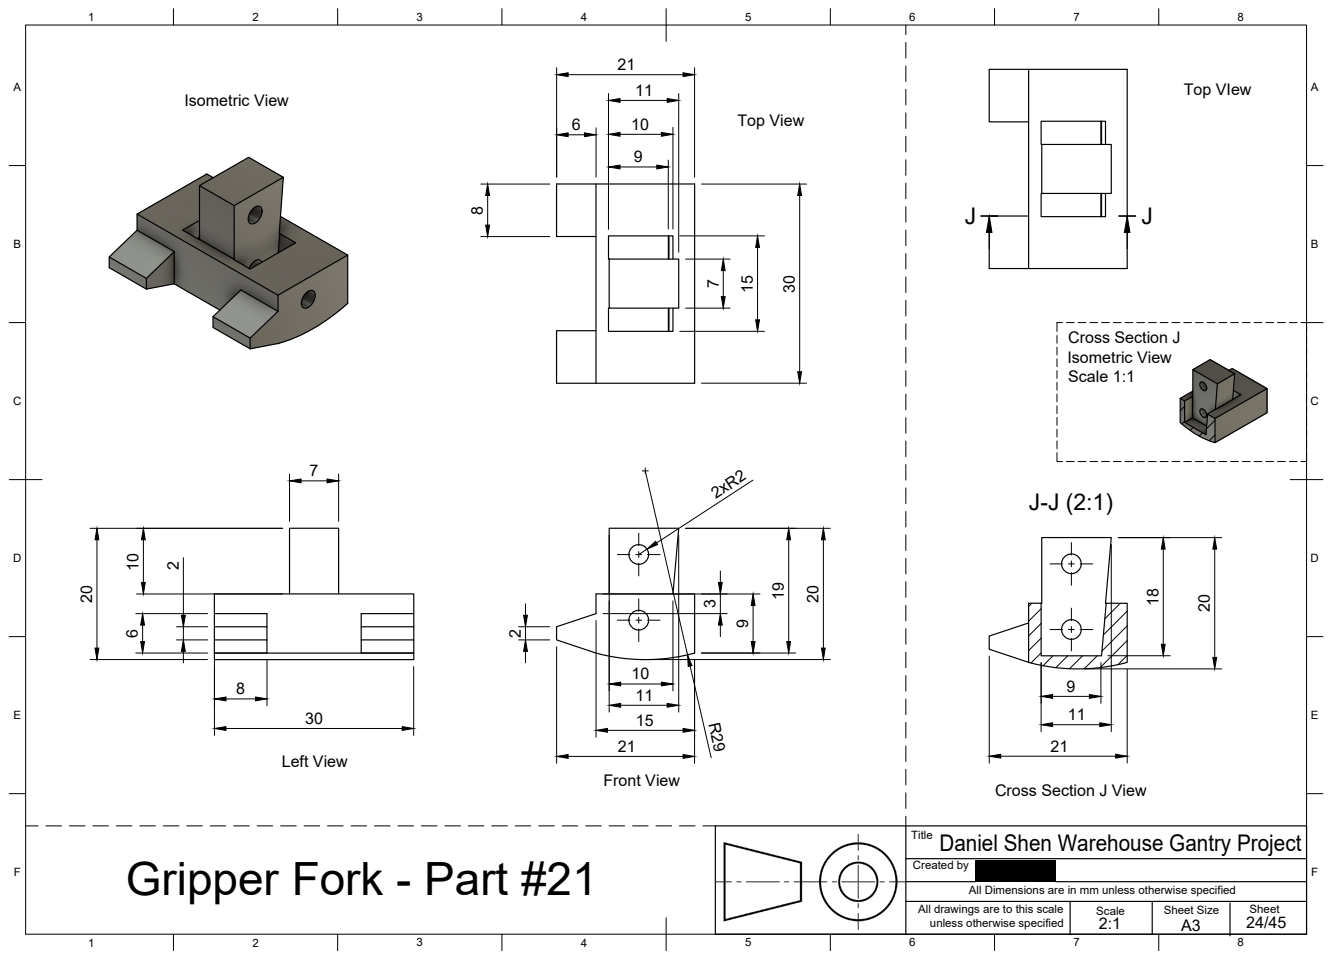
[picture p24: page 24]
Created by; Front View; Left View; Top View; Isometric View; Top VIew; Cross Section J Isometric View Scale 1:1

Cross Section J View

Title
Daniel Shen Warehouse Gantry Project

Gripper Fork - Part #21

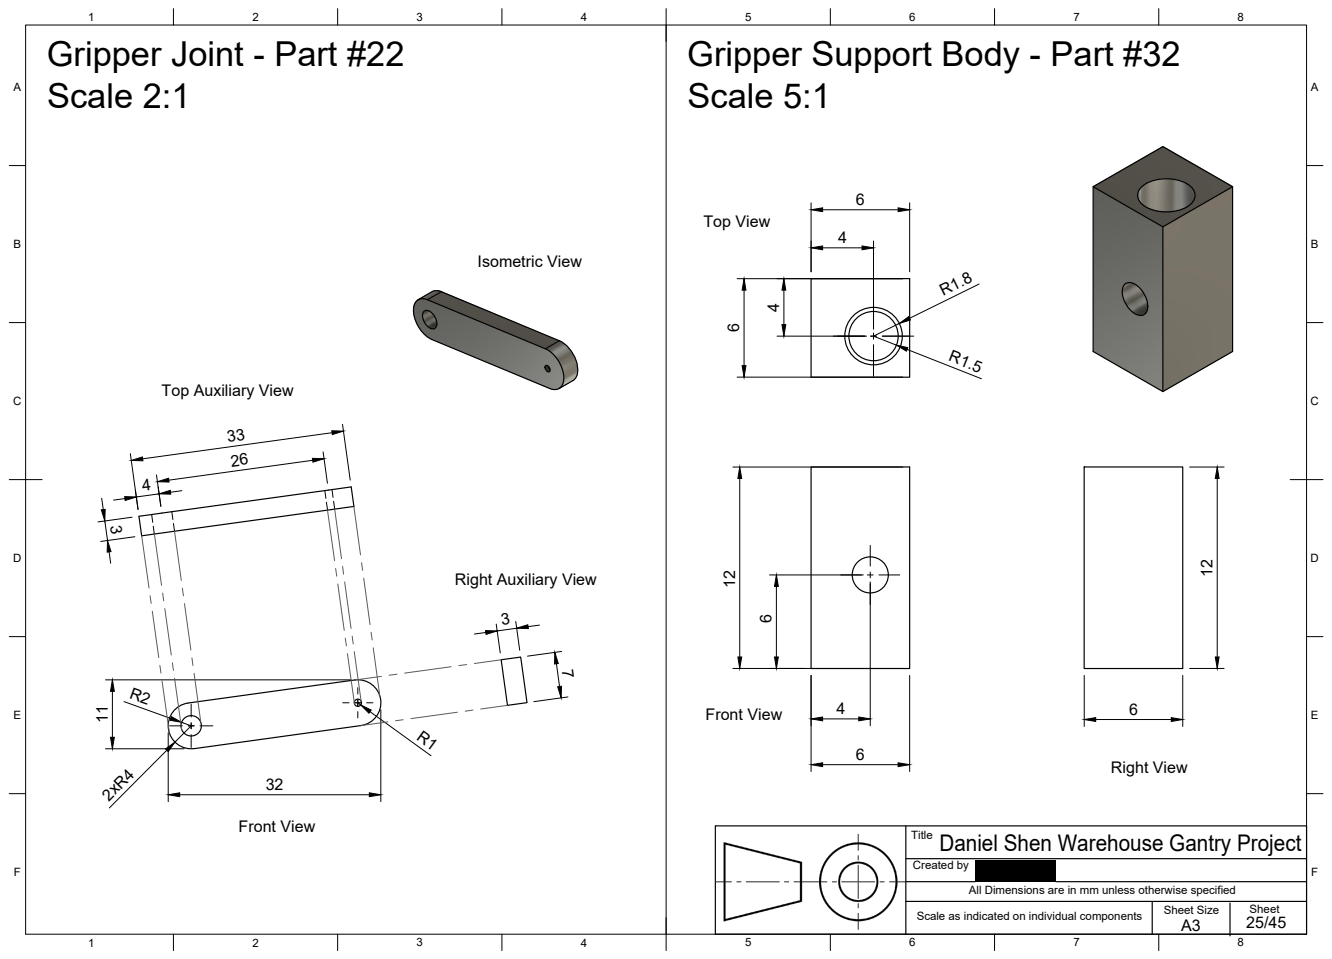
[picture p25: page 25]
Top View; Front View; Right View; Isometric View; Scale as indicated on individual components

Gripper Joint - Part #22
Scale 2:1

Gripper Support Body - Part #32
Scale 5:1

Top Auxiliary View

Right Auxiliary View

Title Daniel Shen Warehouse Gantry Project

Created by

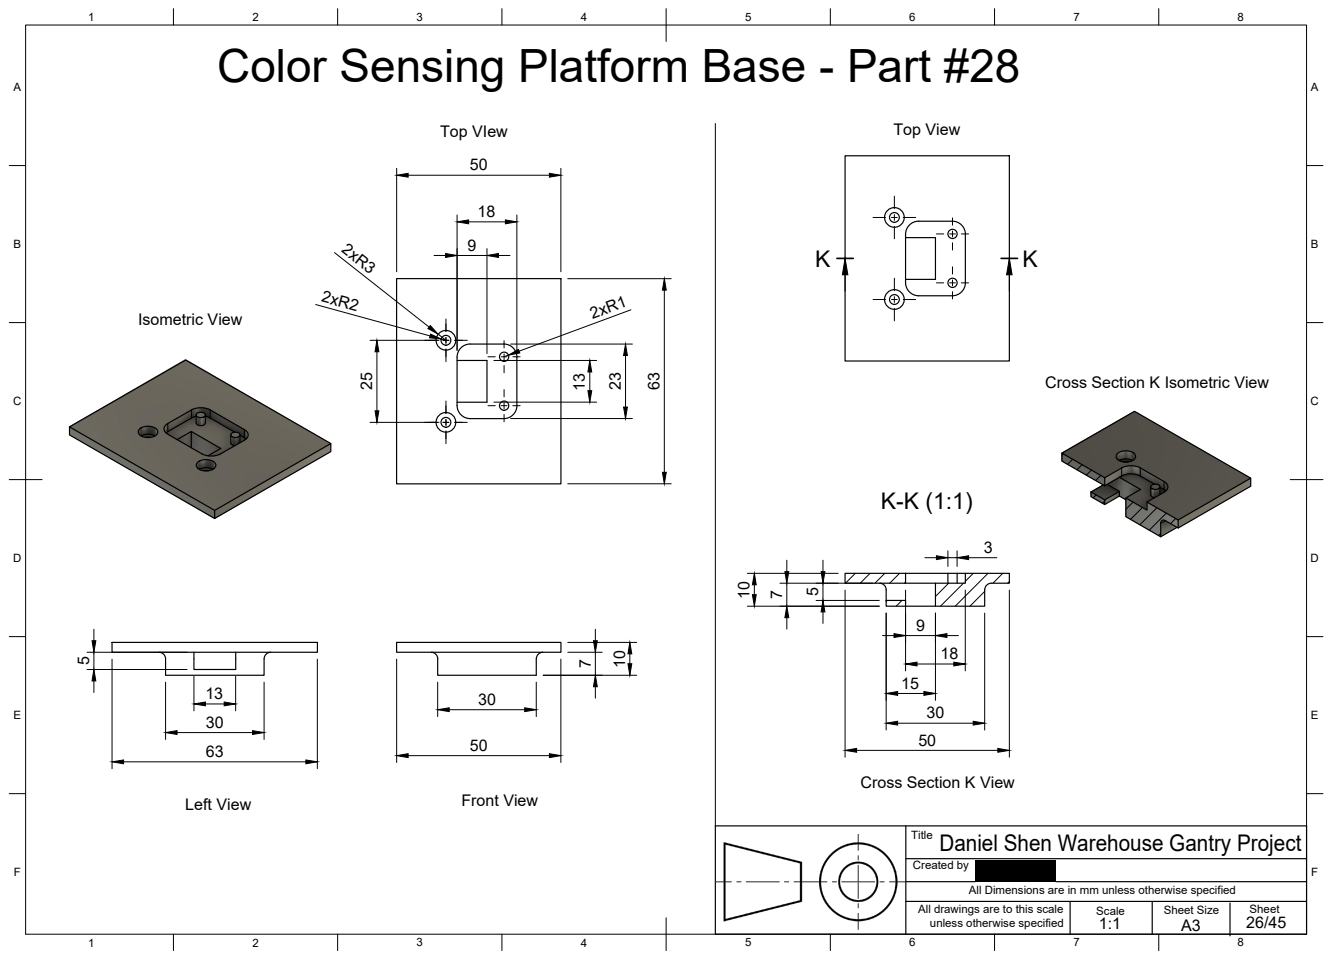
[picture p26: page 26]
Top VIew; Left View; Front View; Isometric View; Top View; Cross Section K View 25; Cross Section K Isometric View

Color Sensing Platform Base - Part #28

Title Daniel Shen Warehouse Gantry Project

Created by

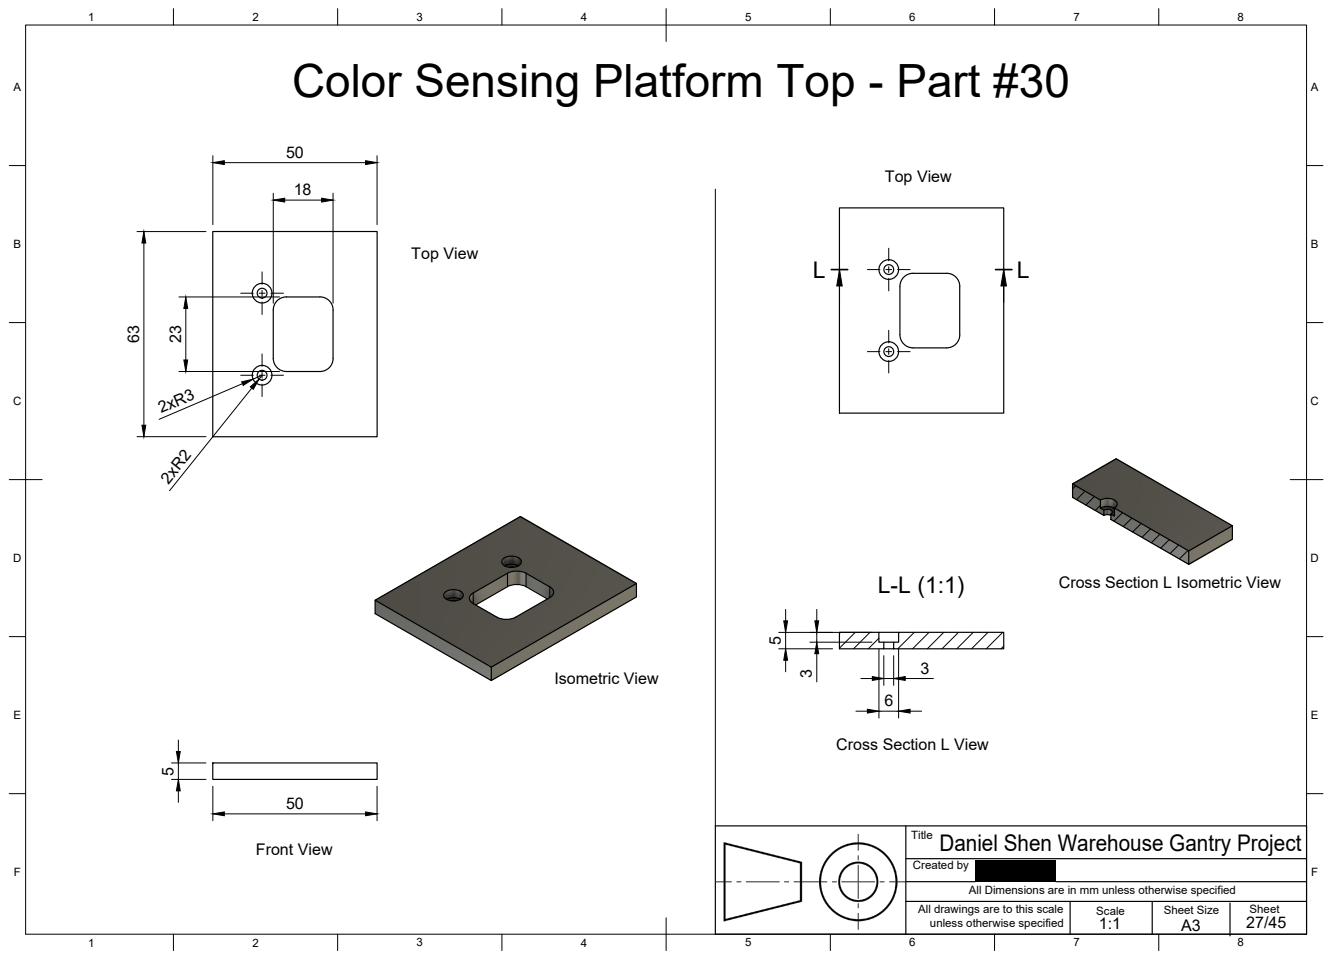
[picture p27: page 27]
Top View; Front View; Isometric View

Color Sensing Platform Top - Part #30

Cross Section L Isometric View

Cross Section L View

Title Daniel Shen Warehouse Gantry Project

Created by

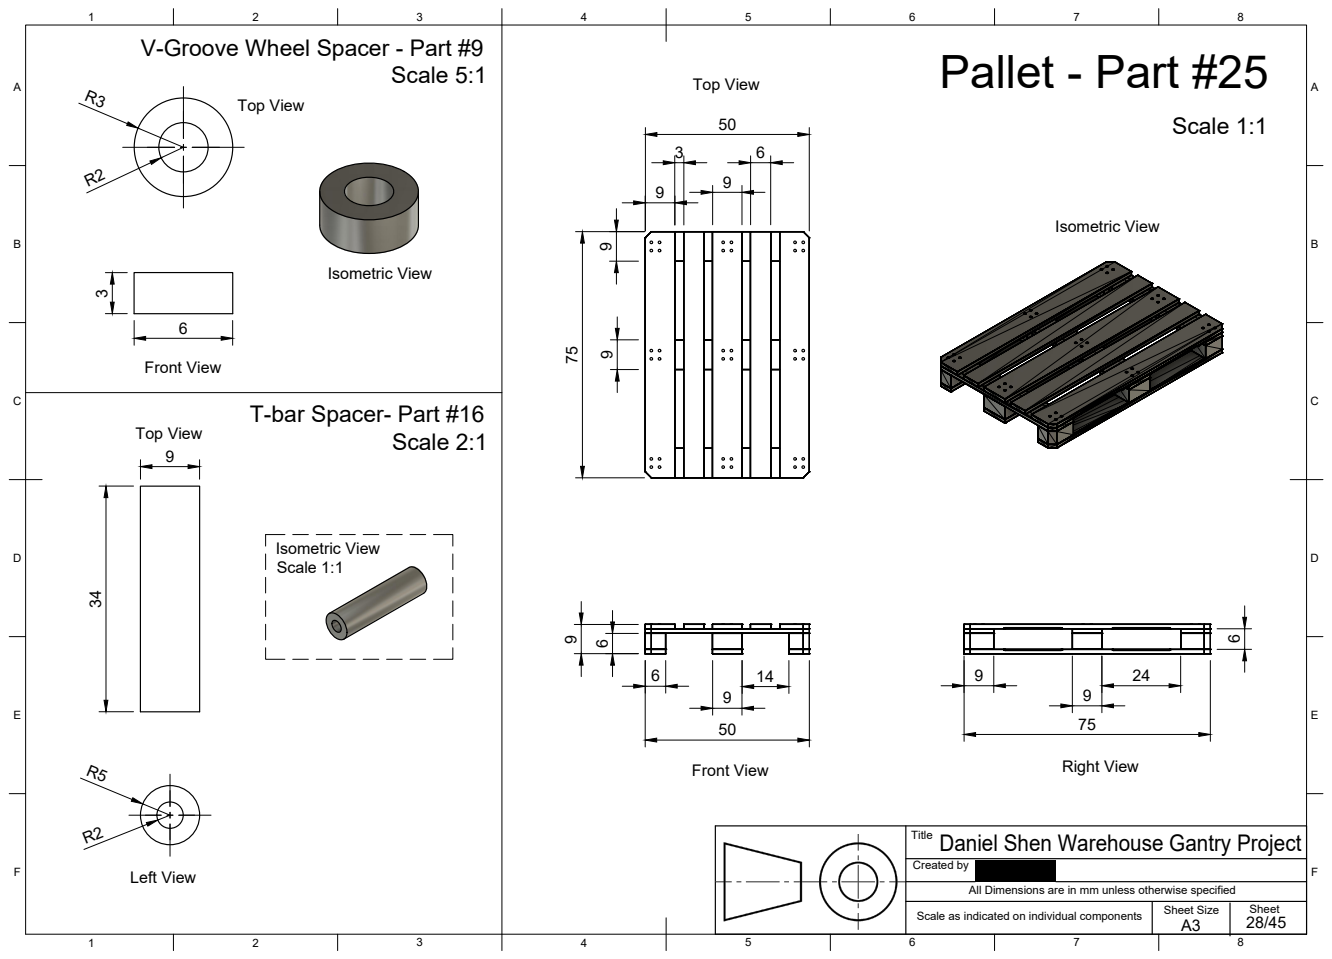
[picture p28: page 28]
Pallet - Part #25; Front View; Right View; Top View; Isometric View; Scale 5:1; Left View; Isometric View Scale 1:1; Scale 2:1; Scale 1:1; Created by; Scale as indicated on individual components

V-Groove Wheel Spacer - Part #9

T-bar Spacer- Part #16

Title
Daniel Shen Warehouse Gantry Project

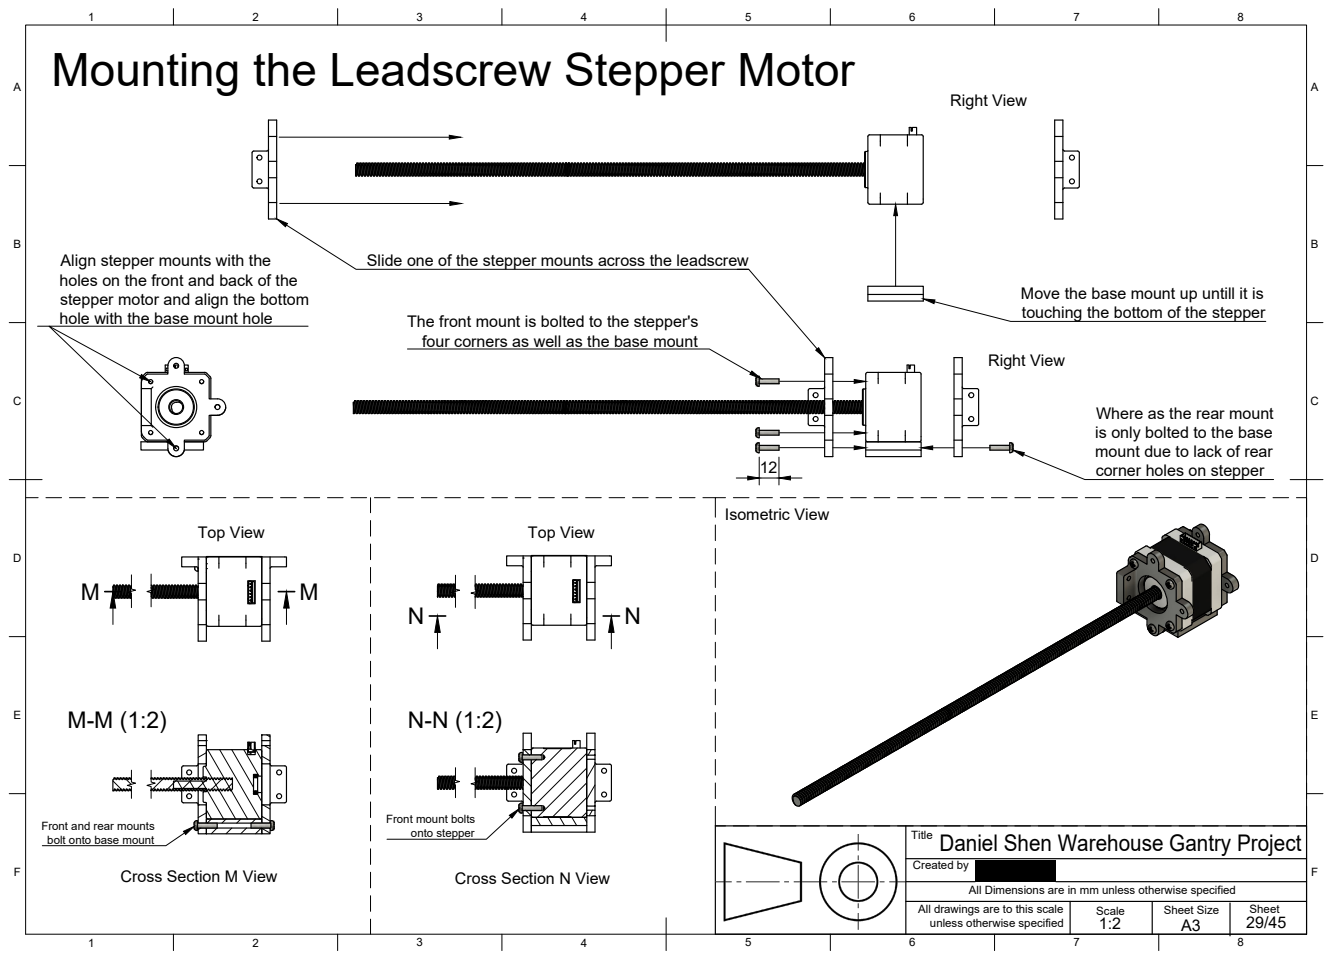
[picture p29: page 29]
Right View; Top View; Cross Section M View; Cross Section N View; Isometric View; Created by

Mounting the Leadscrew Stepper Motor

Align stepper mounts with the
holes on the front and back of the
stepper motor and align the bottom
hole with the base mount hole

Slide one of the stepper mounts across the leadscrew

Move the base mount up untill it is
touching the bottom of the stepper

The front mount is bolted to the stepper's
four corners as well as the base mount

Where as the rear mount
is only bolted to the base
mount due to lack of rear
corner holes on stepper

Front mount bolts
onto stepper

Front and rear mounts
bolt onto base mount

Title
Daniel Shen Warehouse Gantry Project

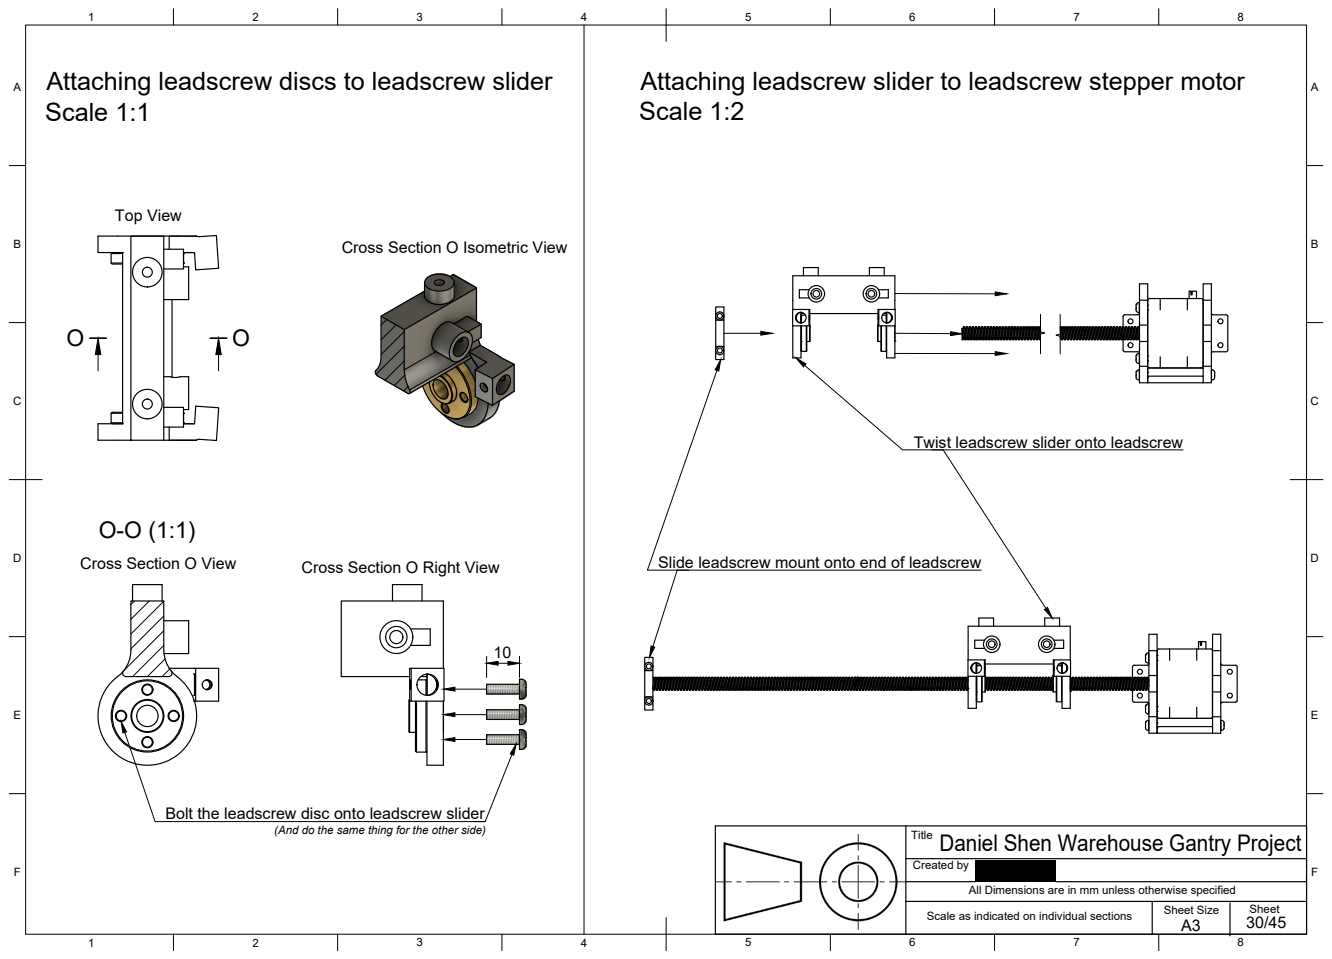
[picture p30: page 30]
Scale as indicated on individual sections; Cross Section O View; Cross Section O Right View; Top View

Attaching leadscrew discs to leadscrew slider
Scale 1:1

Attaching leadscrew slider to leadscrew stepper motor
Scale 1:2

Cross Section O Isometric View

Twist leadscrew slider onto leadscrew

Slide leadscrew mount onto end of leadscrew

Bolt the leadscrew disc onto leadscrew slider

(And do the same thing for the other side)

Title Daniel Shen Warehouse Gantry Project

Created by

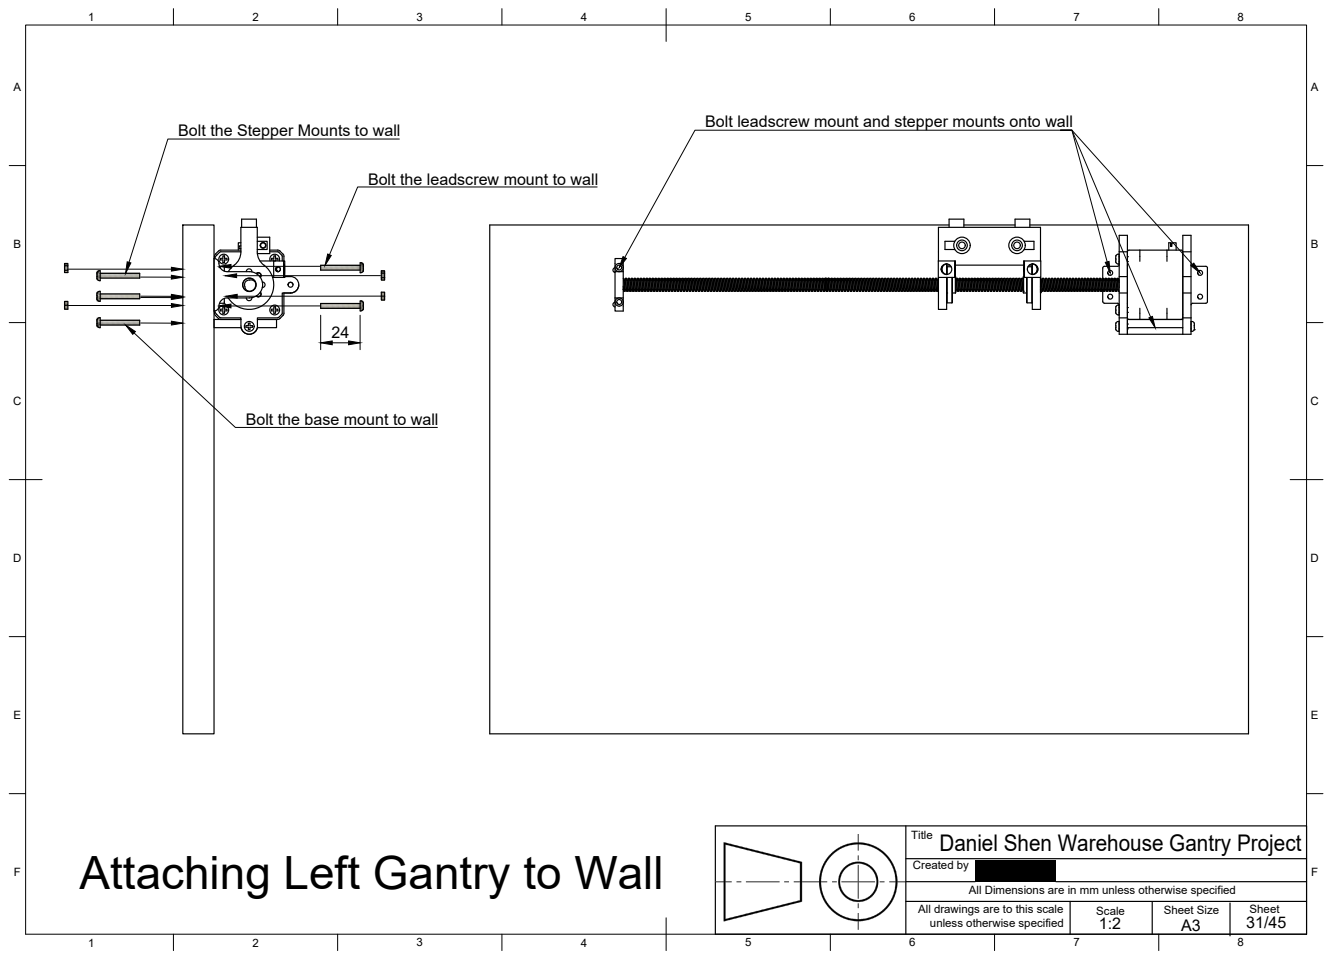
[picture p31: page 31]

Bolt leadscrew mount and stepper mounts onto wall

Bolt the Stepper Mounts to wall

Bolt the leadscrew mount to wall

Bolt the base mount to wall

Title Daniel Shen Warehouse Gantry Project

Attaching Left Gantry to Wall

Created by

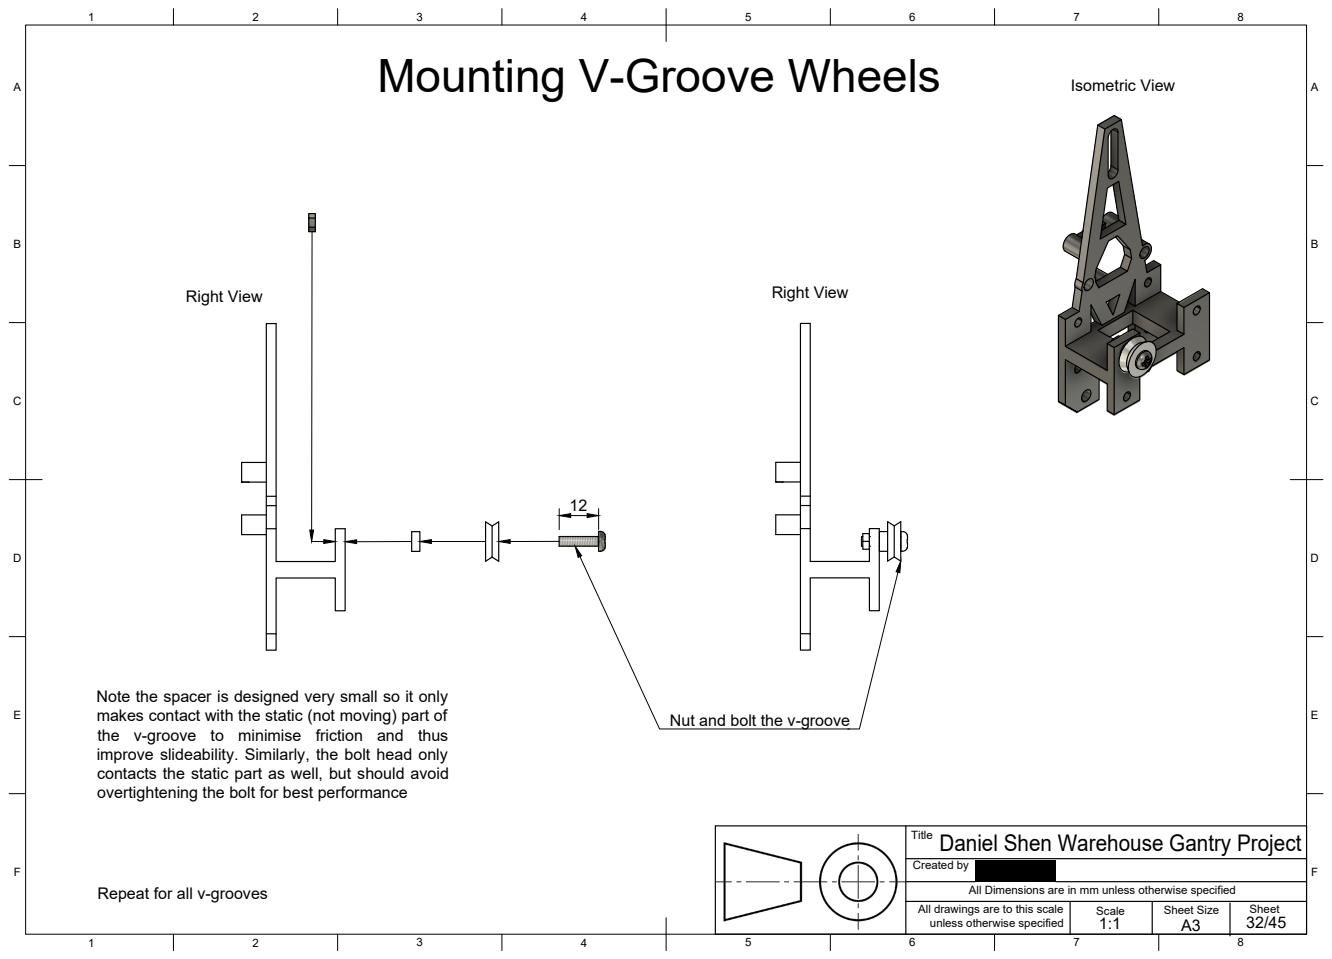
[picture p32: page 32]
Right View; Isometric View

Mounting V-Groove Wheels

Note the spacer is designed very small so it only
makes contact with the static (not moving) part of
the v-groove to minimise friction and thus
improve slideability. Similarly, the bolt head only
contacts the static part as well, but should avoid
overtightening the bolt for best performance

Nut and bolt the v-groove

Title Daniel Shen Warehouse Gantry Project

Created by

Repeat for all v-grooves

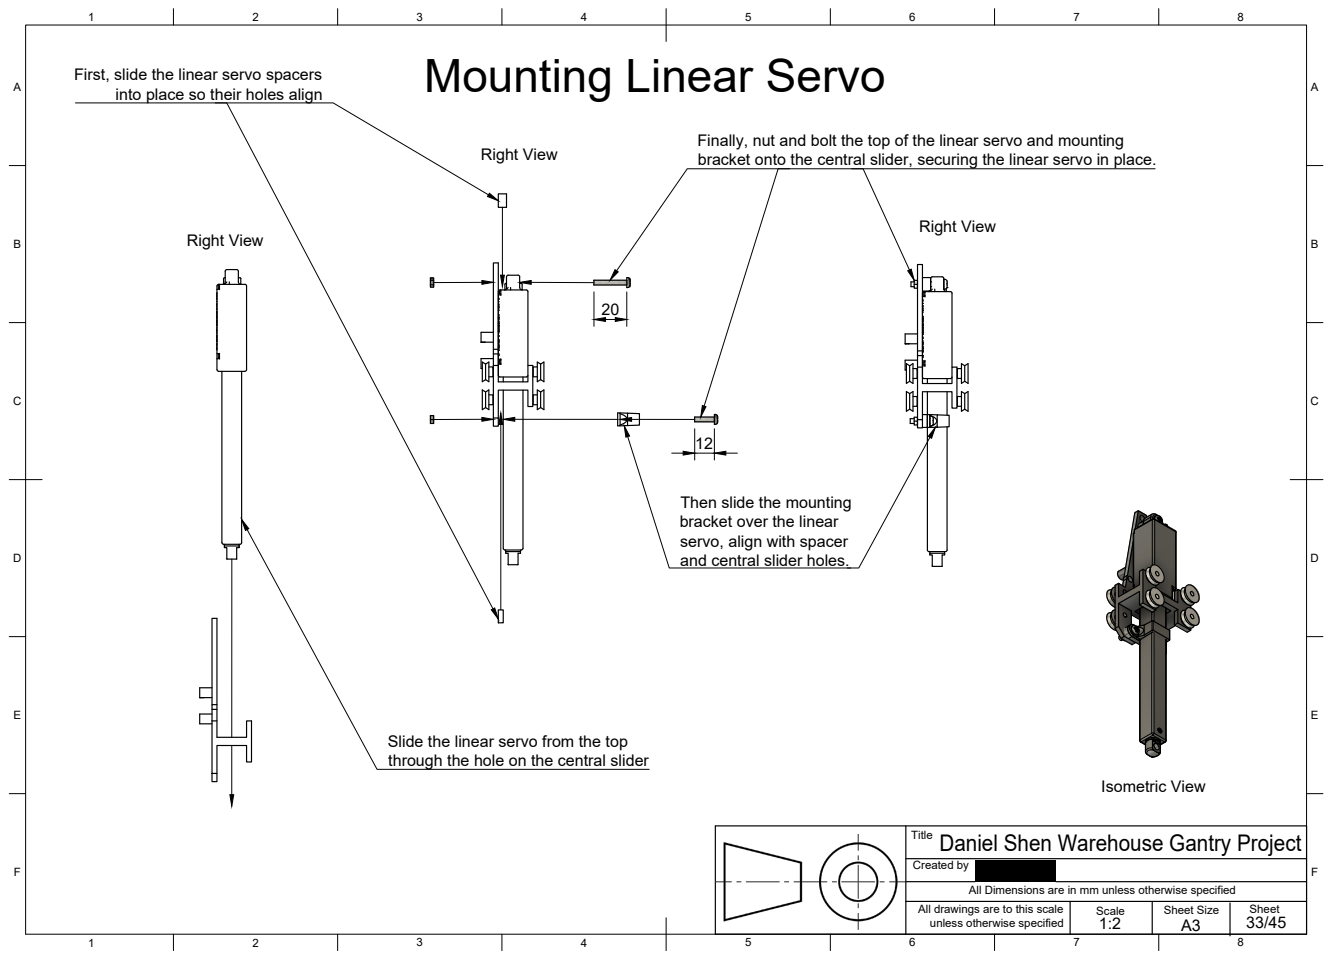
[picture p33: page 33]
Isometric View; Right View

Mounting Linear Servo

First, slide the linear servo spacers
into place so their holes align

Finally, nut and bolt the top of the linear servo and mounting
bracket onto the central slider, securing the linear servo in place.

Then slide the mounting
bracket over the linear
servo, align with spacer
and central slider holes.

Slide the linear servo from the top
through the hole on the central slider

Title Daniel Shen Warehouse Gantry Project

Created by

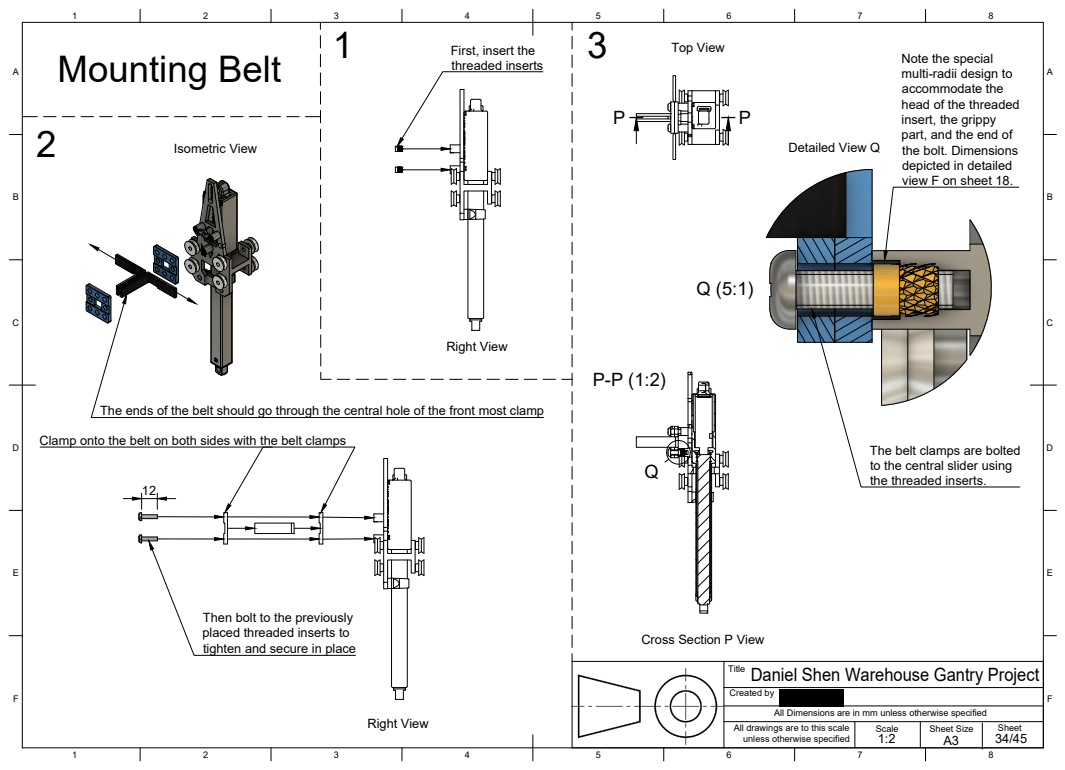
[picture p34: page 34]
Mounting Belt; Right View; Isometric View; Top View; Detailed View Q

First, insert the
threaded inserts

Note the special
multi-radii design to
accommodate the
head of the threaded
insert, the grippy
part, and the end of
the bolt. Dimensions
depicted in detailed
view F on sheet 18.

The ends of the belt should go through the central hole of the front most clamp

Clamp onto the belt on both sides with the belt clamps

The belt clamps are bolted
to the central slider using
the threaded inserts.

Then bolt to the previously
placed threaded inserts to
tighten and secure in place

Cross Section P View

Title Daniel Shen Warehouse Gantry Project

Created by

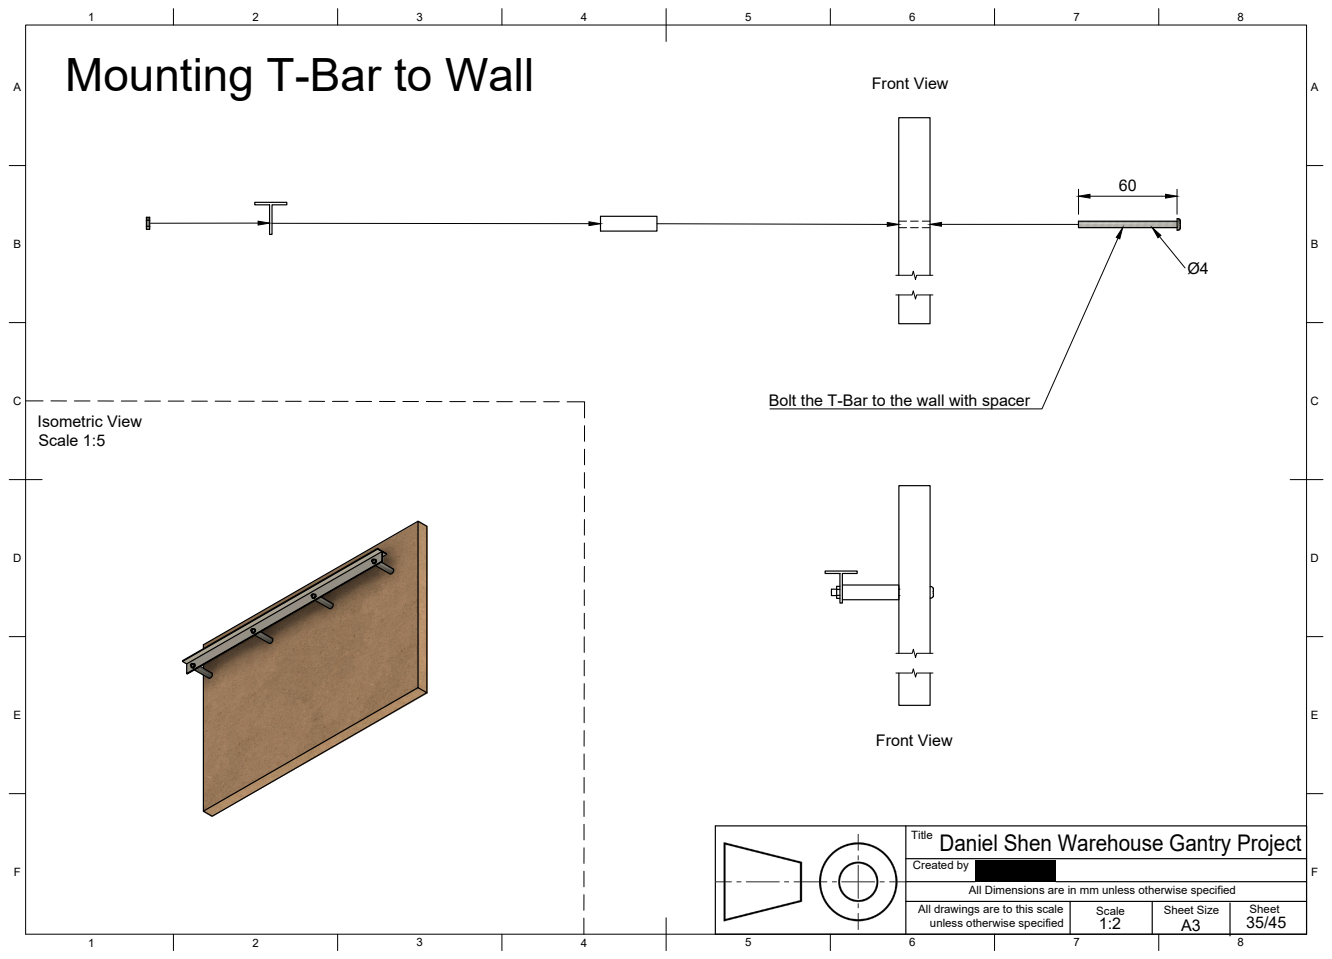
[picture p35: page 35]
Isometric View Scale 1:5; Front View

Mounting T-Bar to Wall

Bolt the T-Bar to the wall with spacer

Title Daniel Shen Warehouse Gantry Project

Created by

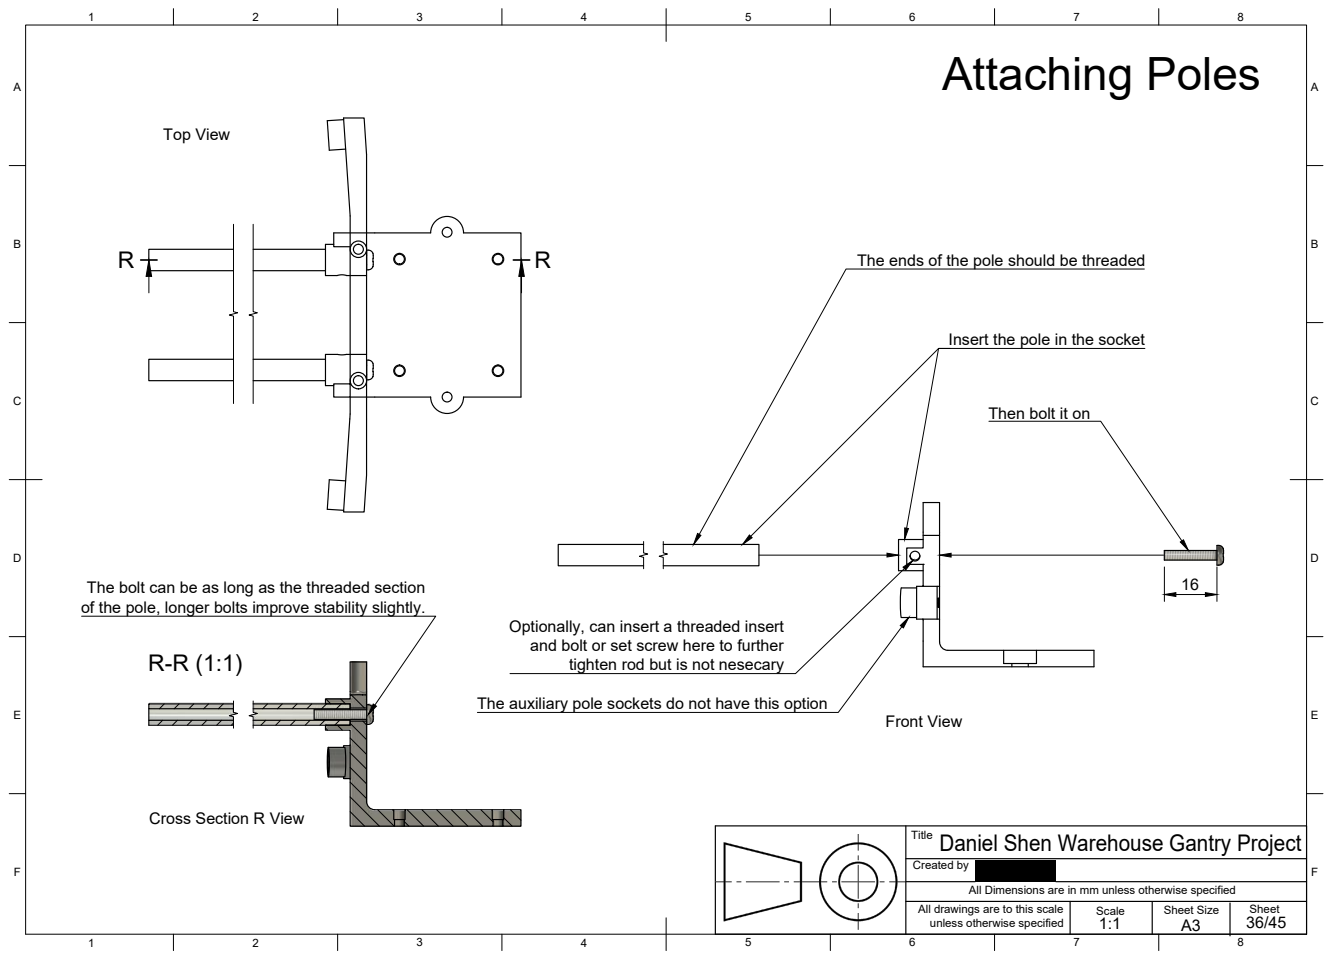
[picture p36: page 36]
Attaching Poles; Top View; Front View

The ends of the pole should be threaded

Insert the pole in the socket

Then bolt it on

The bolt can be as long as the threaded section
of the pole, longer bolts improve stability slightly.

Optionally, can insert a threaded insert
and bolt or set screw here to further
tighten rod but is not nesecary

The auxiliary pole sockets do not have this option

Cross Section R View

Title Daniel Shen Warehouse Gantry Project

Created by

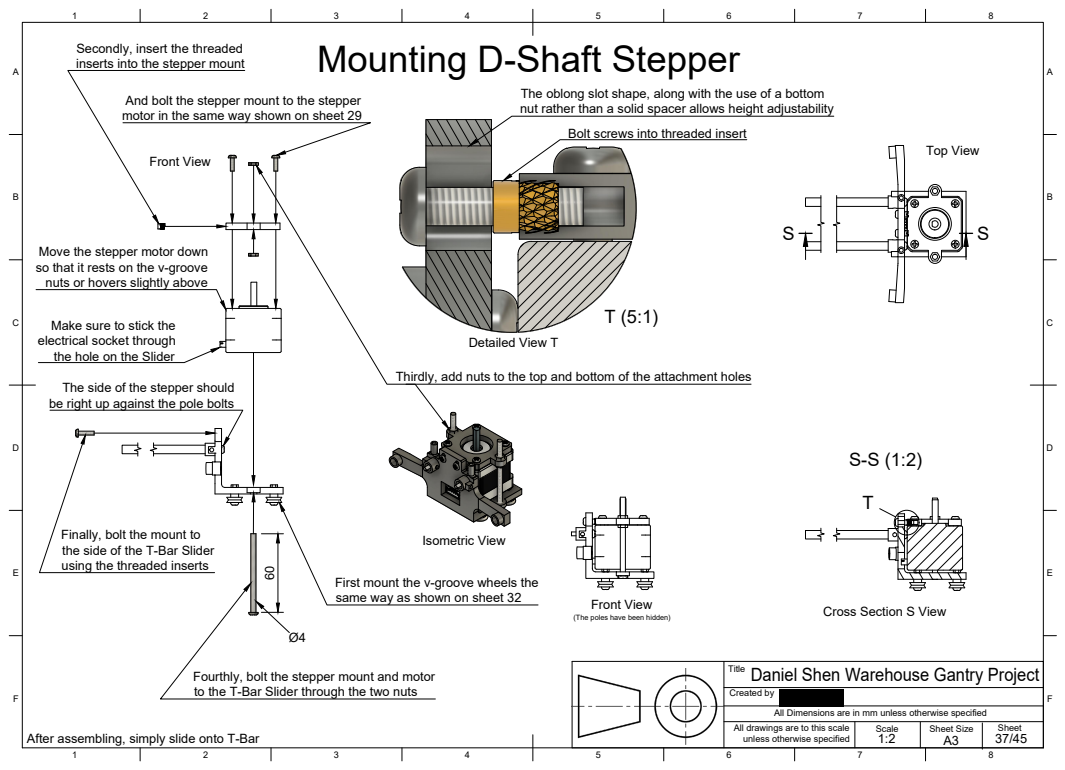
[picture p37: page 37]
Top View; Detailed View T; Front View; Isometric View

Secondly, insert the threaded
inserts into the stepper mount

Mounting D-Shaft Stepper

And bolt the stepper mount to the stepper
motor in the same way shown on sheet 29

The oblong slot shape, along with the use of a bottom
nut rather than a solid spacer allows height adjustability

Bolt screws into threaded insert

Move the stepper motor down
so that it rests on the v-groove
nuts or hovers slightly above

electrical socket through
the hole on the Slider

Make sure to stick the

Thirdly, add nuts to the top and bottom of the attachment holes

The side of the stepper should
be right up against the pole bolts

Finally, bolt the mount to
the side of the T-Bar Slider
using the threaded inserts
After assembling, simply slide onto T-Bar 60

First mount the v-groove wheels the
same way as shown on sheet 32

Cross Section S View

(The poles have been hidden)

Fourthly, bolt the stepper mount and motor
to the T-Bar Slider through the two nuts

Title Daniel Shen Warehouse Gantry Project

Created by

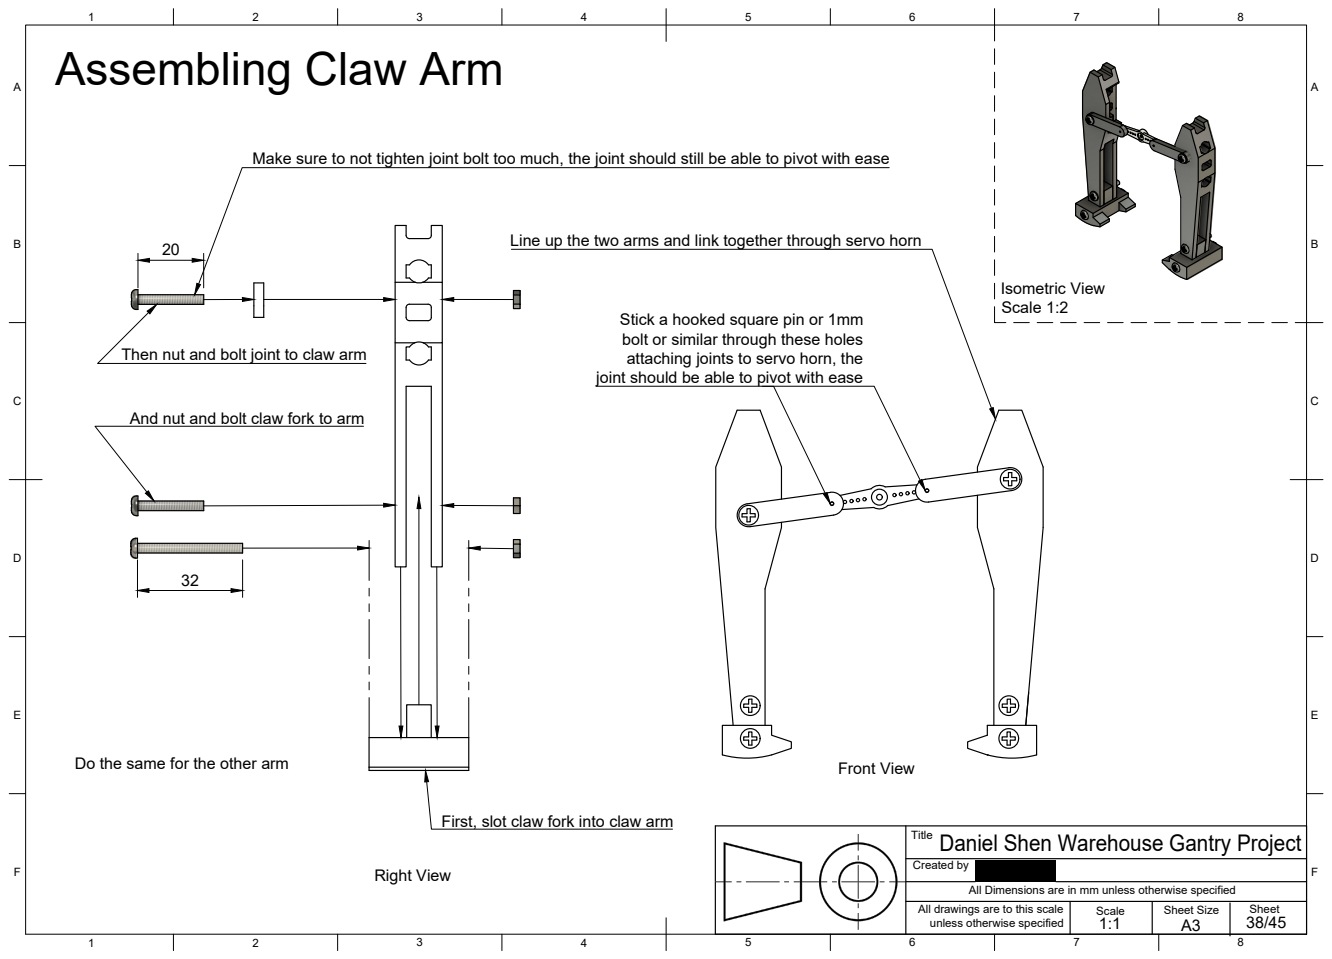
[picture p38: page 38]
Isometric View; Right View; Front View

Assembling Claw Arm

Make sure to not tighten joint bolt too much, the joint should still be able to pivot with ease

Line up the two arms and link together through servo horn

Scale 1:2 Stick a hooked square pin or 1mm

bolt or similar through these holes
attaching joints to servo horn, the
joint should be able to pivot with ease

Then nut and bolt joint to claw arm

And nut and bolt claw fork to arm

Do the same for the other arm

First, slot claw fork into claw arm

Title Daniel Shen Warehouse Gantry Project

Created by

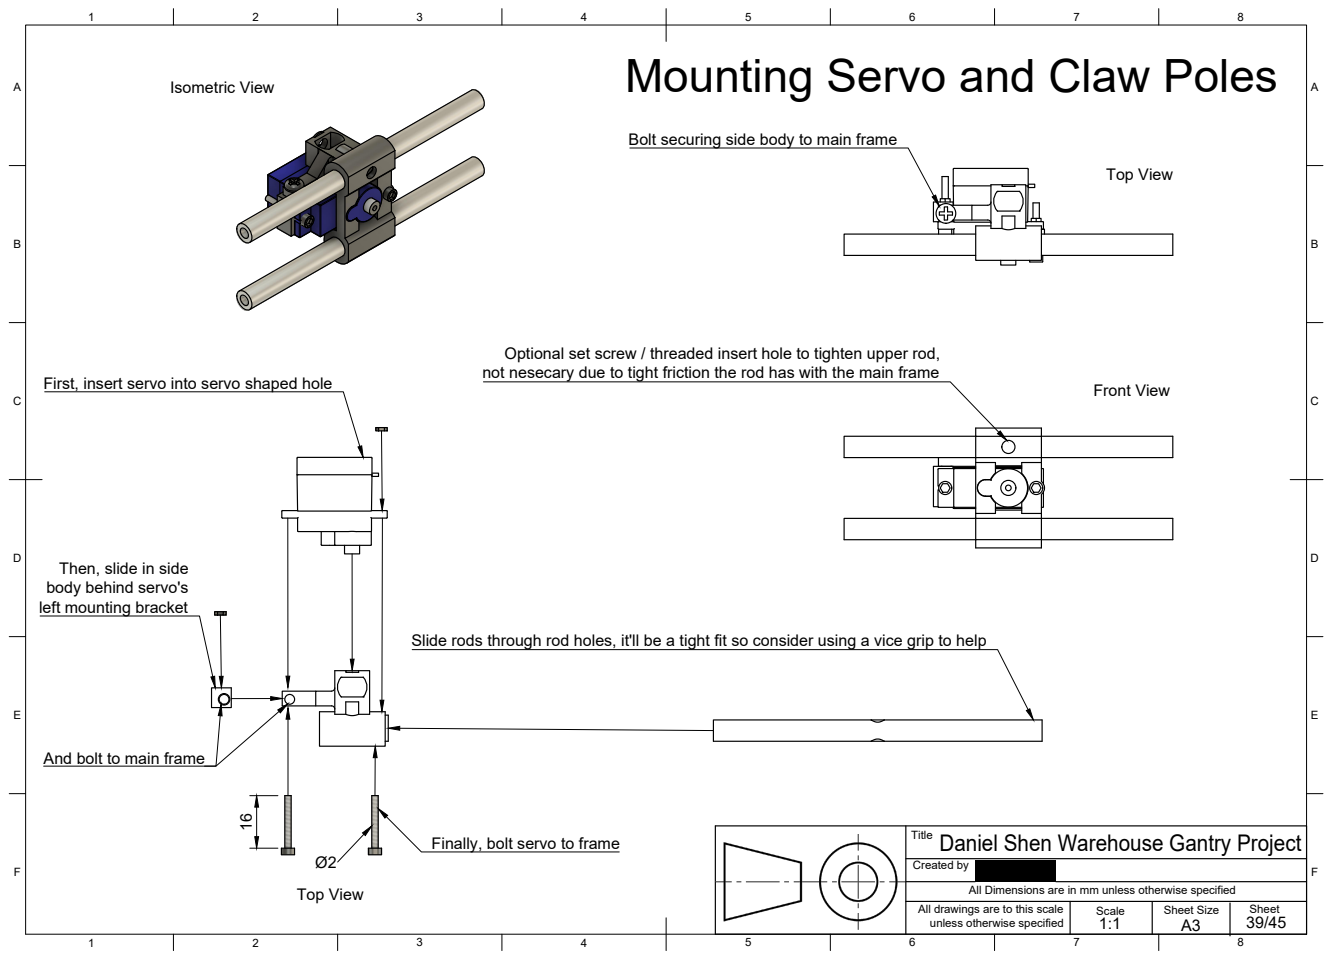
[picture p39: page 39]
Isometric View; Top View; Front View

Mounting Servo and Claw Poles 16

Bolt securing side body to main frame

Optional set screw / threaded insert hole to tighten upper rod,
not nesecary due to tight friction the rod has with the main frame

First, insert servo into servo shaped hole

body behind servo's
left mounting bracket

Then, slide in side

Slide rods through rod holes, it'll be a tight fit so consider using a vice grip to help

And bolt to main frame

Finally, bolt servo to frame

Title Daniel Shen Warehouse Gantry Project

Created by

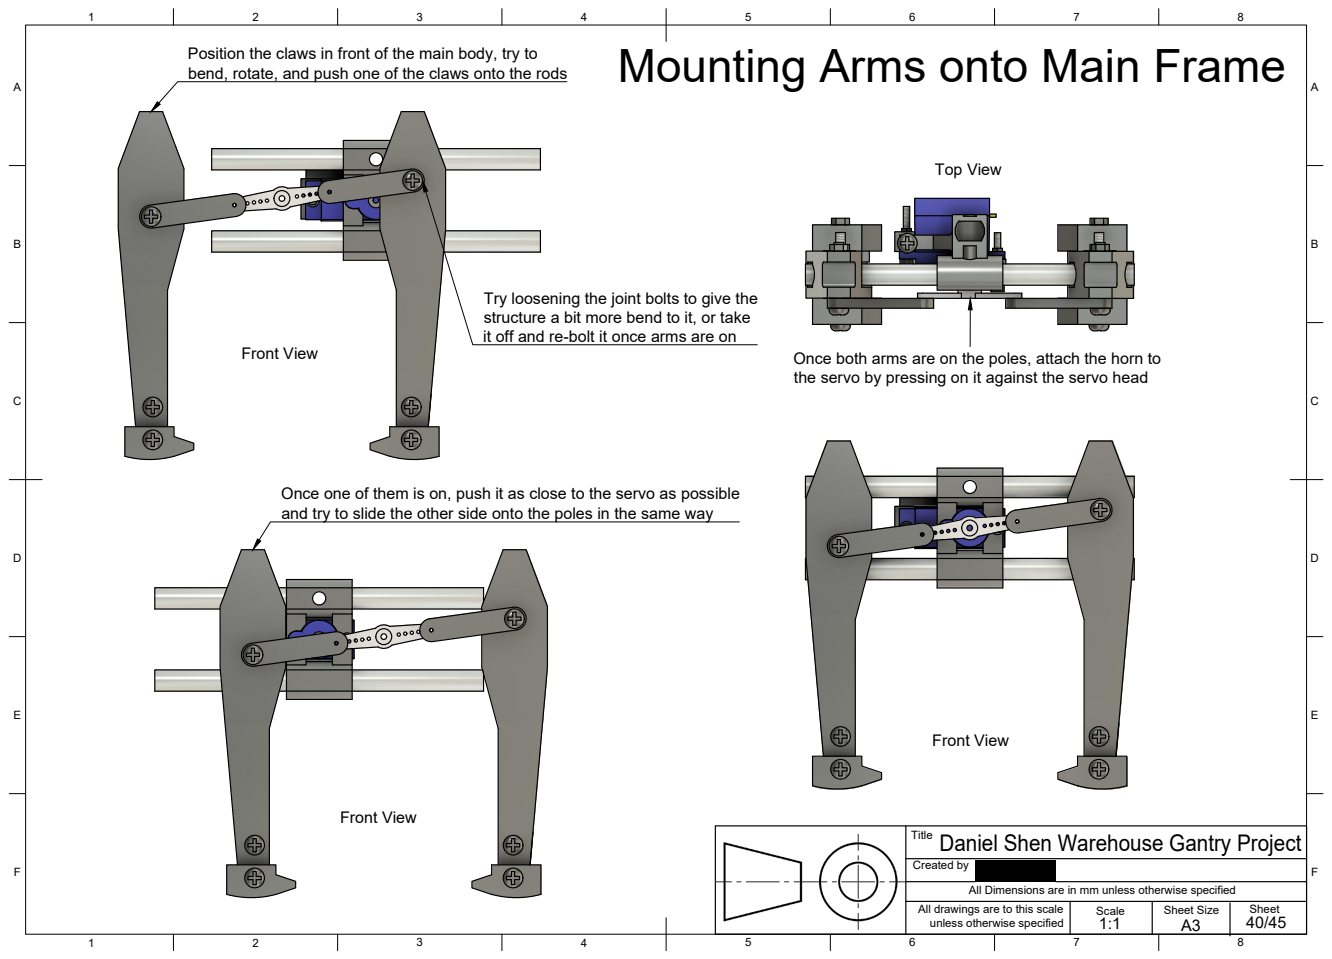
[picture p40: page 40]
Front View; Top View

Position the claws in front of the main body, try to
bend, rotate, and push one of the claws onto the rods

Mounting Arms onto Main Frame

Try loosening the joint bolts to give the
structure a bit more bend to it, or take
it off and re-bolt it once arms are on

Once both arms are on the poles, attach the horn to
the servo by pressing on it against the servo head

Once one of them is on, push it as close to the servo as possible
and try to slide the other side onto the poles in the same way

Title Daniel Shen Warehouse Gantry Project

Created by

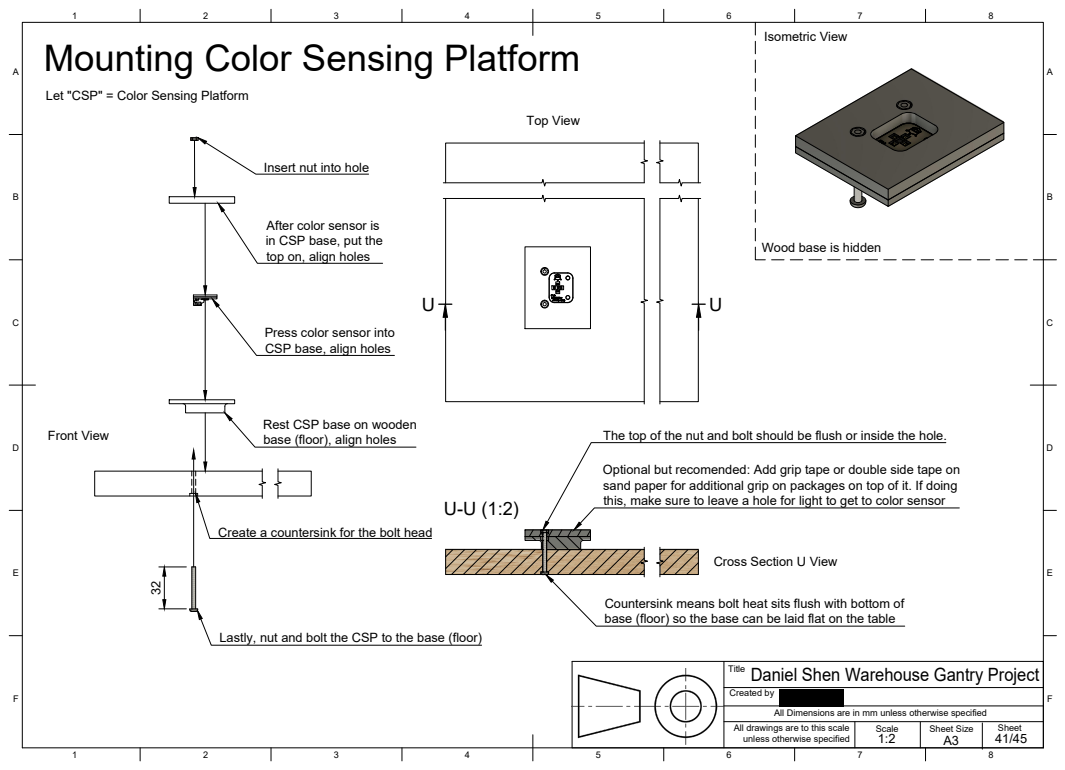
[picture p41: page 41]
Isometric View; Top View; Front View

Mounting Color Sensing Platform

Let "CSP" = Color Sensing Platform

Insert nut into hole

After color sensor is
in CSP base, put the
top on, align holes

Wood base is hidden 32

Press color sensor into
CSP base, align holes

Rest CSP base on wooden
base (floor), align holes

The top of the nut and bolt should be flush or inside the hole.

Optional but recomended: Add grip tape or double side tape on
sand paper for additional grip on packages on top of it. If doing
this, make sure to leave a hole for light to get to color sensor

Create a countersink for the bolt head

Cross Section U View

Countersink means bolt heat sits flush with bottom of
base (floor) so the base can be laid flat on the table

Lastly, nut and bolt the CSP to the base (floor)

Title Daniel Shen Warehouse Gantry Project

Created by

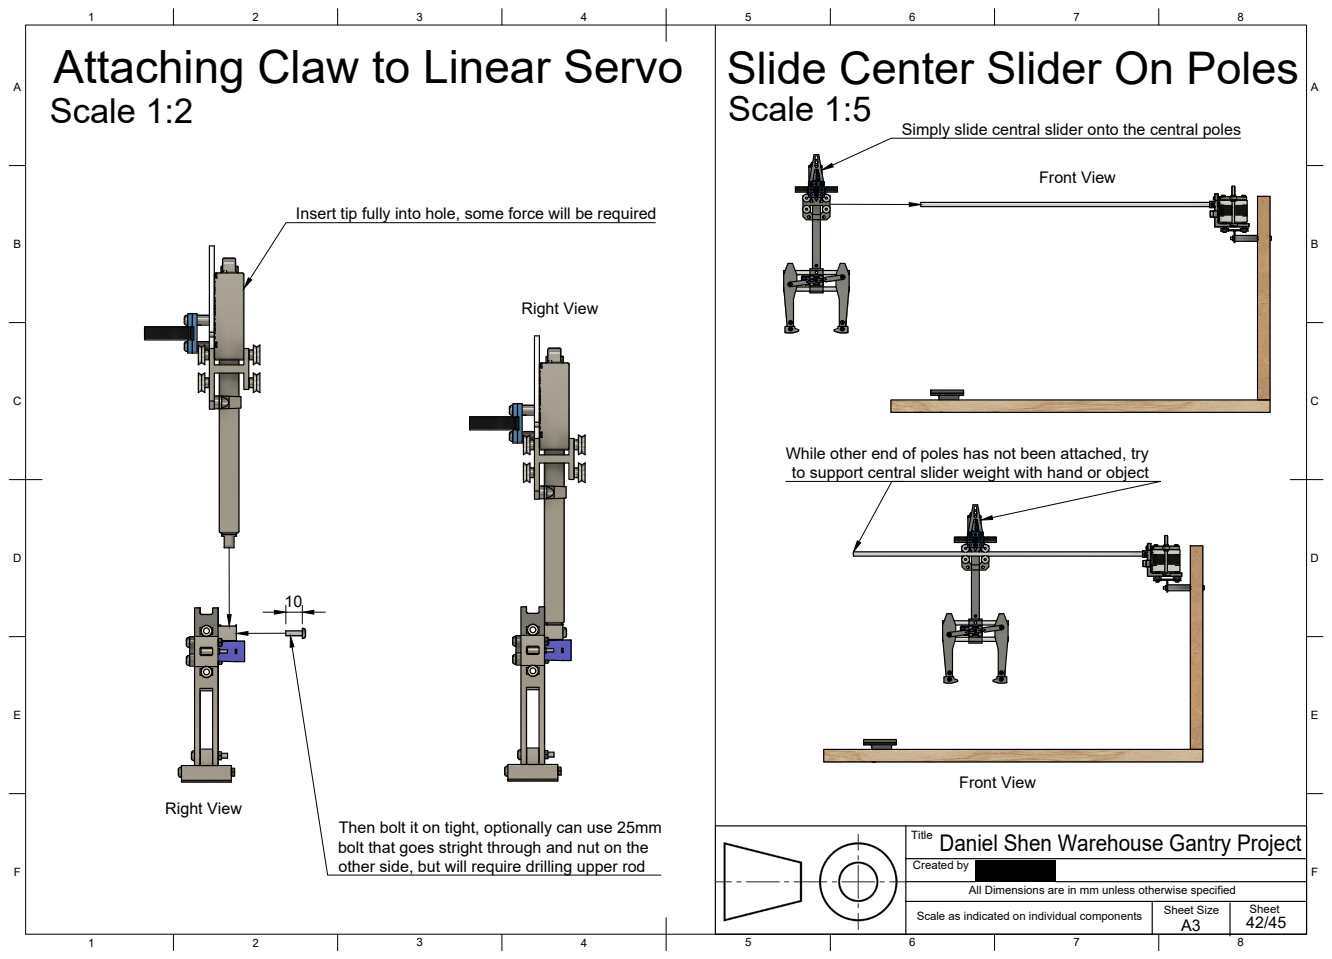
[picture p42: page 42]
Scale as indicated on individual components; Front View; Right View

Attaching Claw to Linear Servo
Scale 1:2

Slide Center Slider On Poles
Scale 1:5

Simply slide central slider onto the central poles

Insert tip fully into hole, some force will be required

While other end of poles has not been attached, try
to support central slider weight with hand or object

Then bolt it on tight, optionally can use 25mm
bolt that goes stright through and nut on the
other side, but will require drilling upper rod

Title Daniel Shen Warehouse Gantry Project

Created by

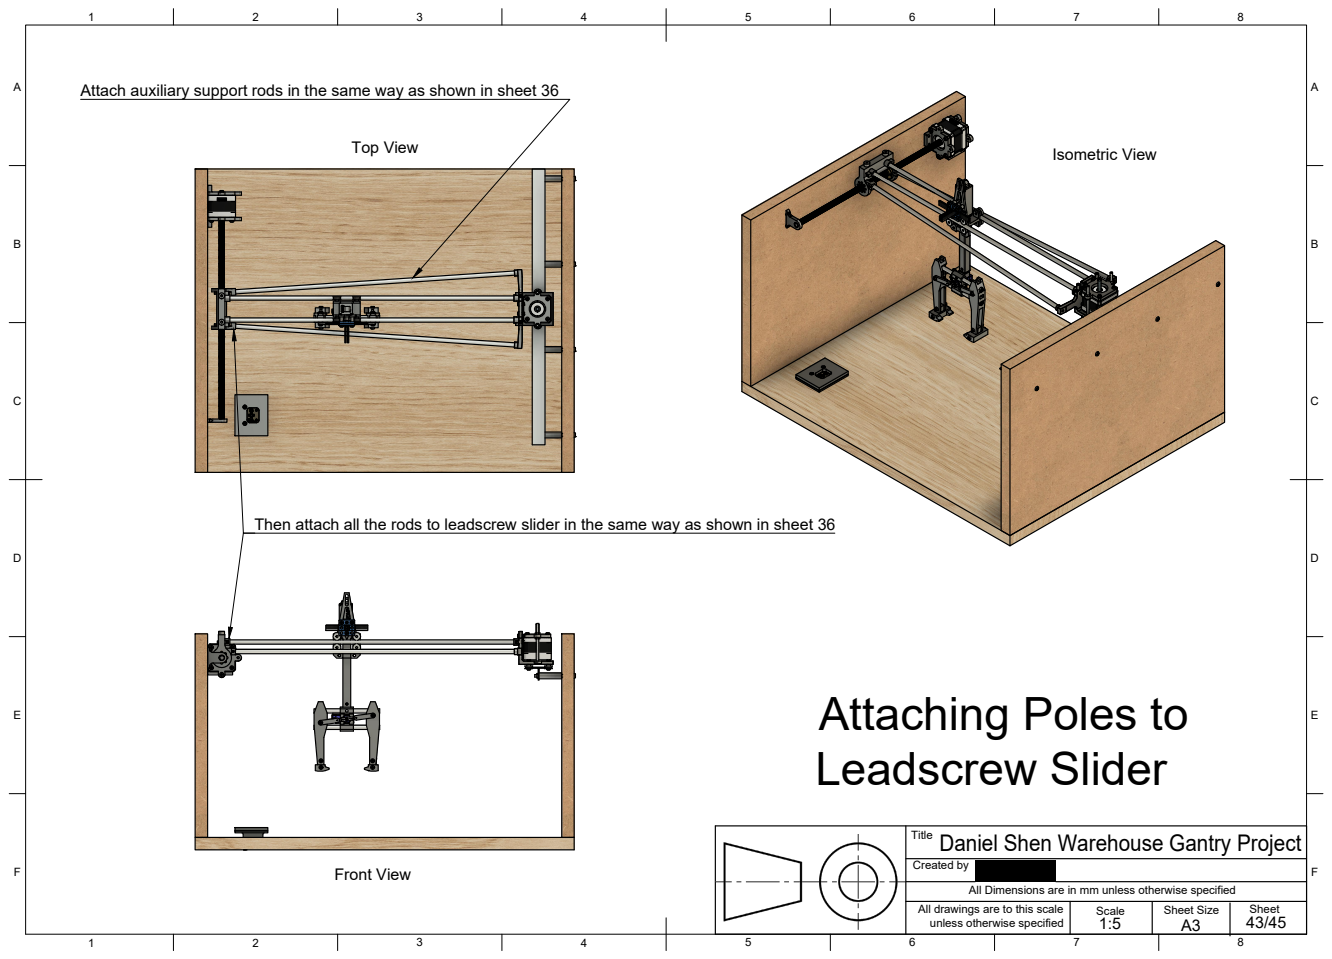
[picture p43: page 43]
Created by; Top View; Front View; Isometric View

Attach auxiliary support rods in the same way as shown in sheet 36

Then attach all the rods to leadscrew slider in the same way as shown in sheet 36

Attaching Poles to
Leadscrew Slider

Title
Daniel Shen Warehouse Gantry Project

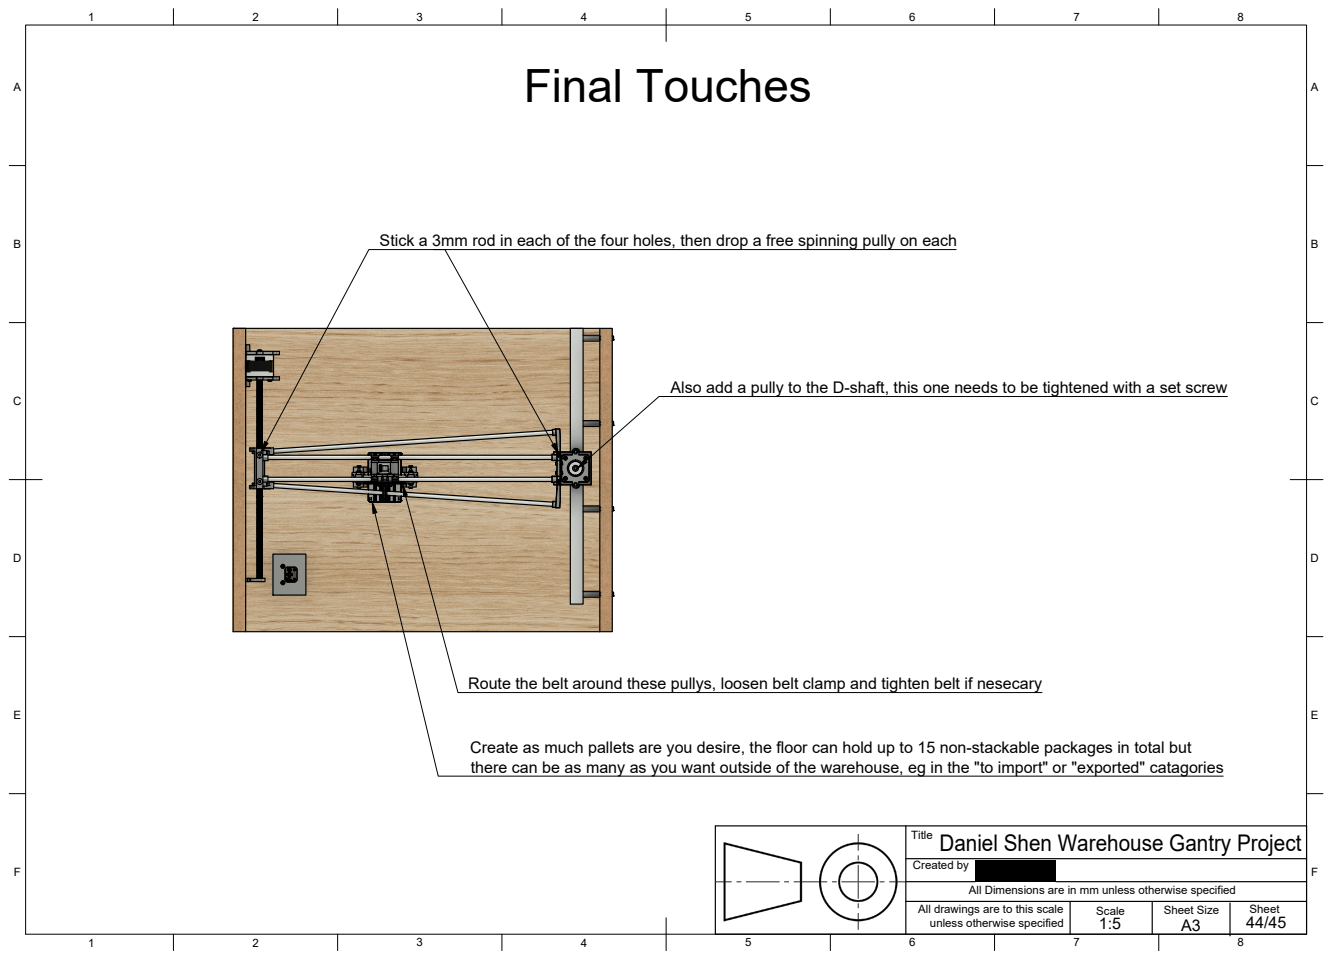
[picture p44: page 44]
Created by; Final Touches

Stick a 3mm rod in each of the four holes, then drop a free spinning pully on each

Also add a pully to the D-shaft, this one needs to be tightened with a set screw

Route the belt around these pullys, loosen belt clamp and tighten belt if nesecary

Create as much pallets are you desire, the floor can hold up to 15 non-stackable packages in total but
there can be as many as you want outside of the warehouse, eg in the "to import" or "exported" catagories

Title
Daniel Shen Warehouse Gantry Project

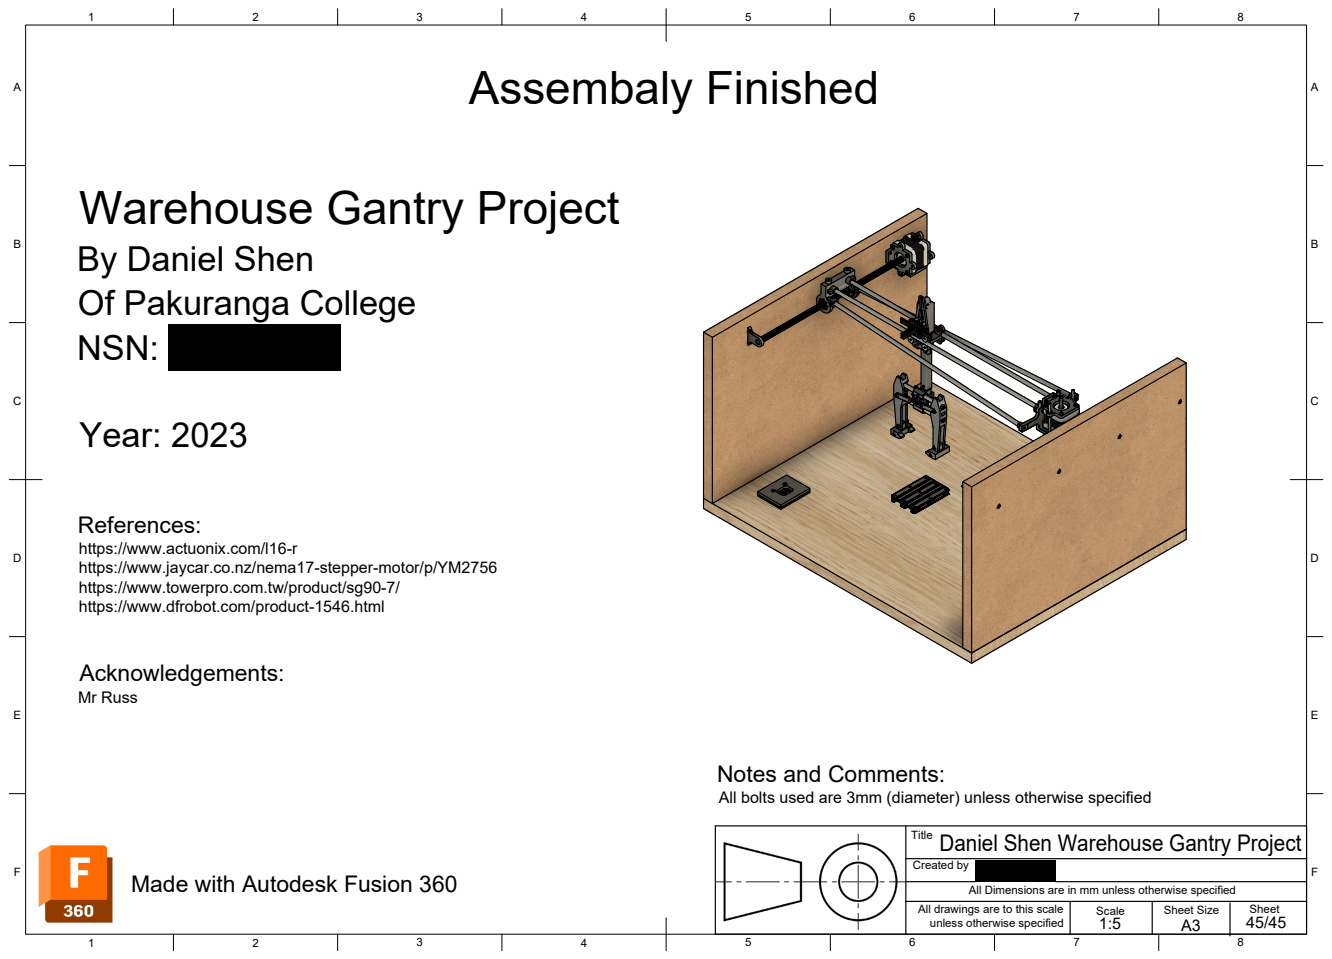
[picture p45: page 45]
Created by; Assembaly Finished; Year: 2023; Mr Russ

Warehouse Gantry Project
By Daniel Shen
Of Pakuranga College
NSN:

References:
https://www.actuonix.com/l16-r
https://www.jaycar.co.nz/nema17-stepper-motor/p/YM2756
https://www.towerpro.com.tw/product/sg90-7/
https://www.dfrobot.com/product-1546.html

Notes and Comments:
All bolts used are 3mm (diameter) unless otherwise specified

Title
Daniel Shen Warehouse Gantry Project

Made with Autodesk Fusion 360
