MrDanS-21/gantry-system-23/(list of files, drawings)

Other design files:
V1/GantrySystemPCB2023.dip
